psas/lv3.0-camera-ring/README.md

# lv3.0-camera-ring
LV3 360 degree camera ring
