psas/lv3.0-camera-ring/Camera Ring/360_RunCam_Ring.SLDASM

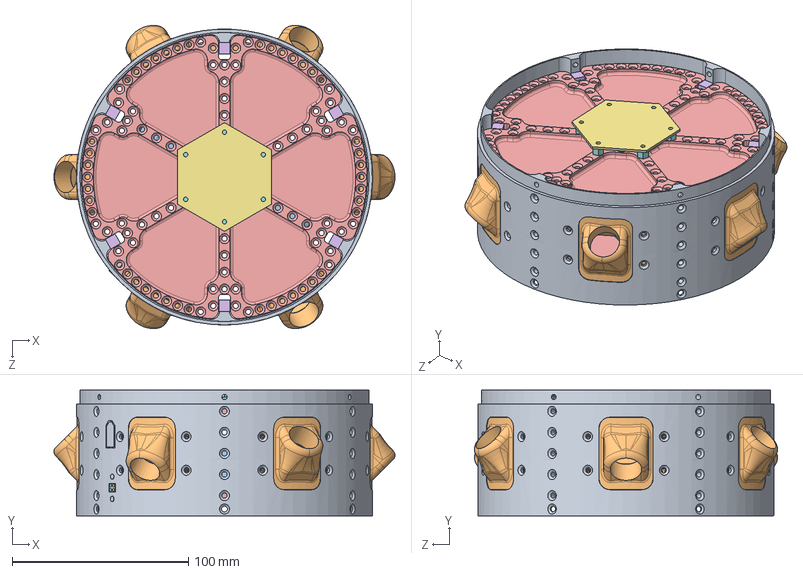
[picture p3: CAD file, 2018-02-22]
Camera Ring/360_RunCam_Ring.SLDASM
193.2 x 71.1 x 171.8 mm
360_RunCam_Ring
RunCam Cradle x 6
4-40x0.375_torx_socketHead_92610A106_BLACK-OXIDE ALLOY STEEL SOCKET HEAD CAP SCREW x 6
No4x0.312_clippedWasher_96025A124_STEEL ANTI-ROTATING CLIPPED WASHER x 6
Camera Bulkhead x 2
bulkheadBracket x 12
Camera Control Board
Stand Off x 6
XT-60_Macho
PinoXT-60_Macho x 2
FUNDA
NUCLEO
JST XHP-4
XT60 Buchse
813-22-0xx-30-000101-Single x 2
0900-0-15-20-76-14-11-0-Housing x 4
Magnet x 2
Camera Cradle Clamp
