psas/lv3.0-camera-ring/mechanical/fireHazard/batteryBox.SLDASM

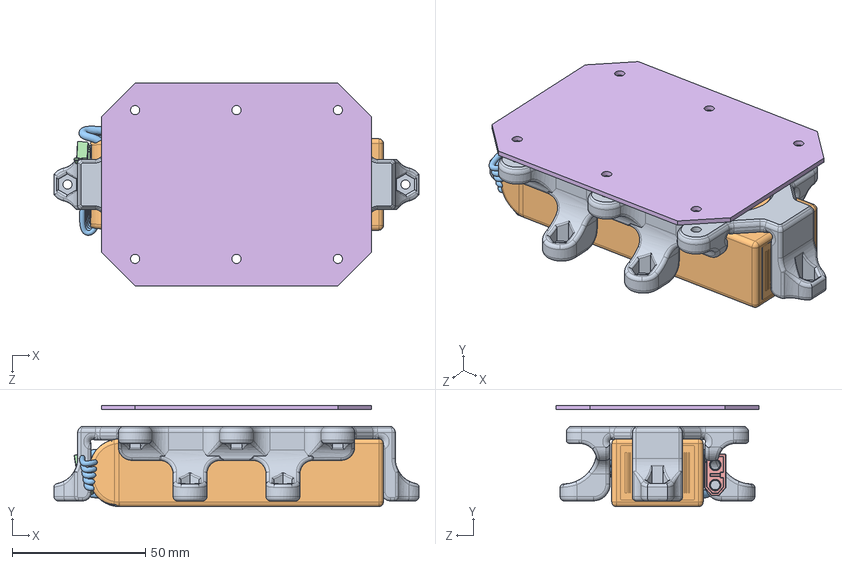
[picture p4: CAD file, 2018-04-08]
mechanical/fireHazard/batteryBox.SLDASM
137.2 x 38.0 x 76.2 mm
batteryDome
FUNDA
NUCLEO
JST XHP-4
XT60 Buchse
cameraMasterBoard
