psas/lv3.0-camera-ring/mechanical/camera/horizontalCradle.SLDASM

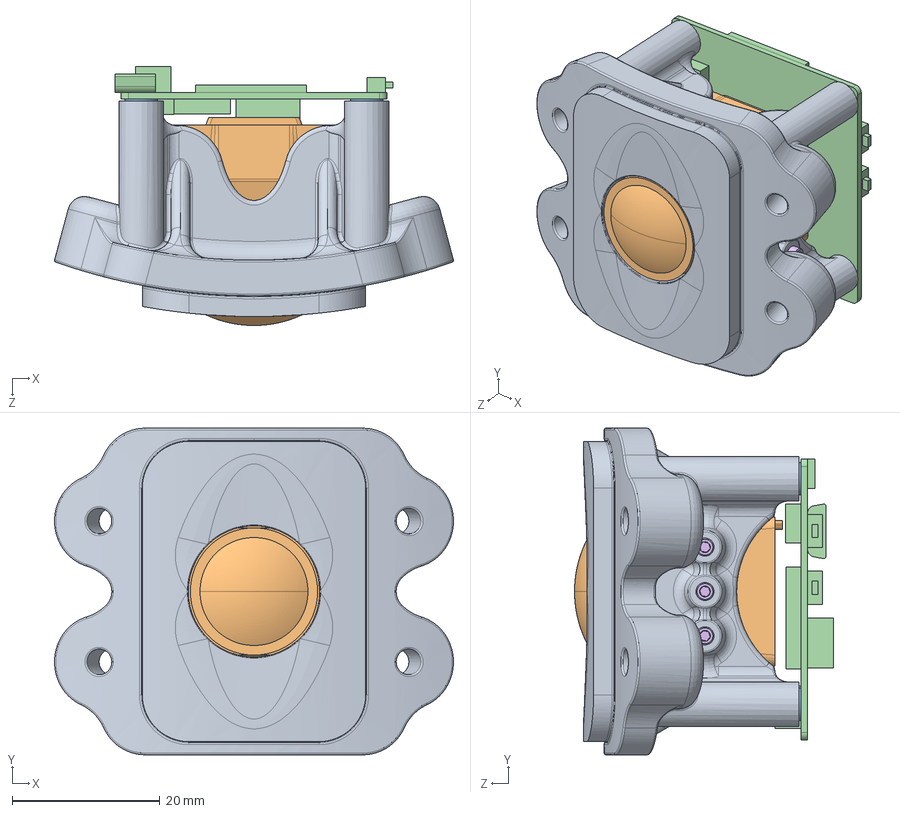
[picture p5: CAD file, 2018-03-23]
mechanical/camera/horizontalCradle.SLDASM
54.0 x 44.2 x 35.0 mm
horizontalCradle
Cam-gopro-lens
4-40_heatInsert_93365A122_BRASS HEAT-SET INSERT FOR PLASTICS x 4
Split-Platine
0-80_nut_91841A115_TYPE 18-8 STAINLESS STEEL HEX NUT x 6
0-80x0.25_capHeadScrew_91251A055_BLACK-OXIDE ALLOY STEEL SOCKET HEAD CAP SCREW x 6
