psas/lv3.0-camera-ring/mechanical/camera/axialCradle.SLDASM

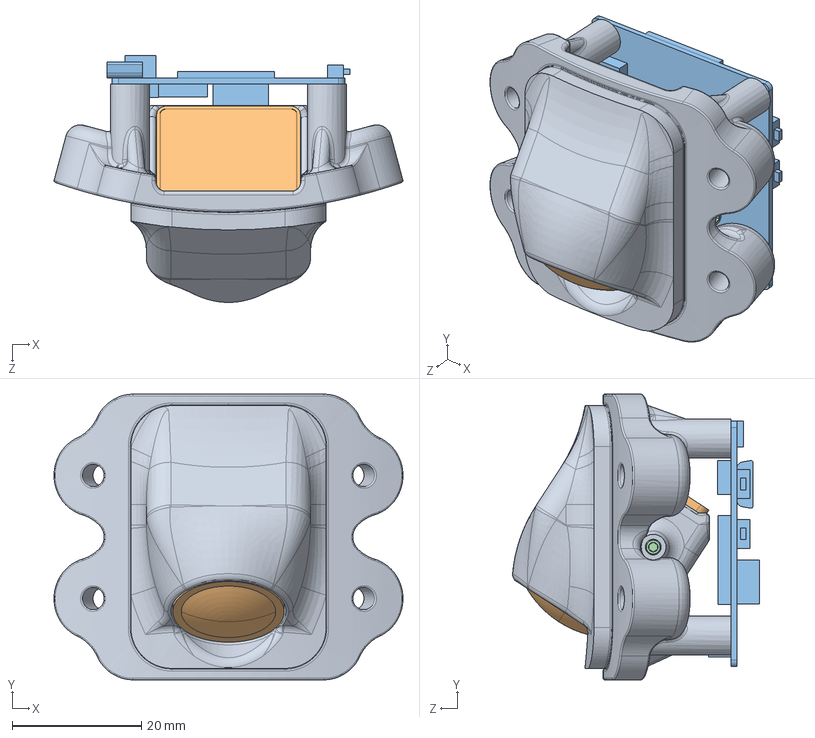
[picture p6: CAD file, 2018-03-23]
mechanical/camera/axialCradle.SLDASM
54.0 x 44.2 x 38.2 mm
axialCradle
Cam-gopro-lens
Split-Platine
0-80x0.25_capHeadScrew_91251A055_BLACK-OXIDE ALLOY STEEL SOCKET HEAD CAP SCREW x 2
0-80_nut_91841A115_TYPE 18-8 STAINLESS STEEL HEX NUT x 2
