psas/lv3.0-camera-ring/mechanical/camera/runCamCradle.SLDASM

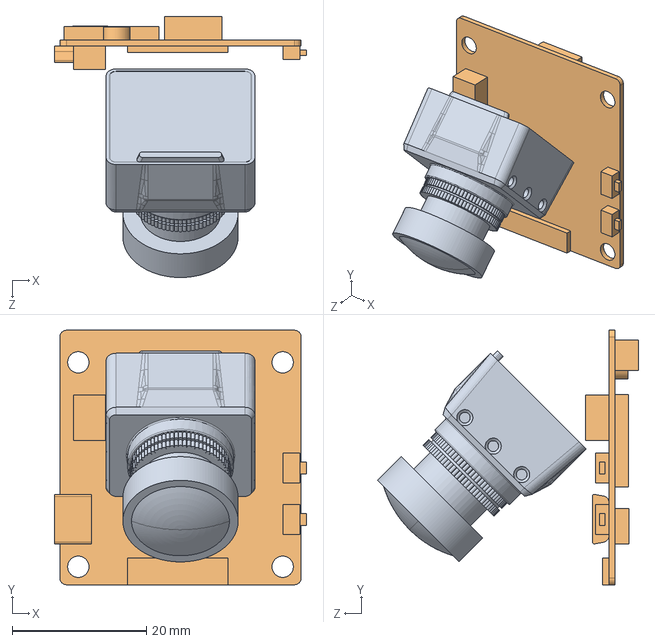
[picture p7: CAD file, 2018-03-09]
mechanical/camera/runCamCradle.SLDASM
37.6 x 38.0 x 38.9 mm
Cam-gopro-lens
Split-Platine
