psas/lv3.0-camera-ring/mechanical/structure/umbilicalRing.SLDASM

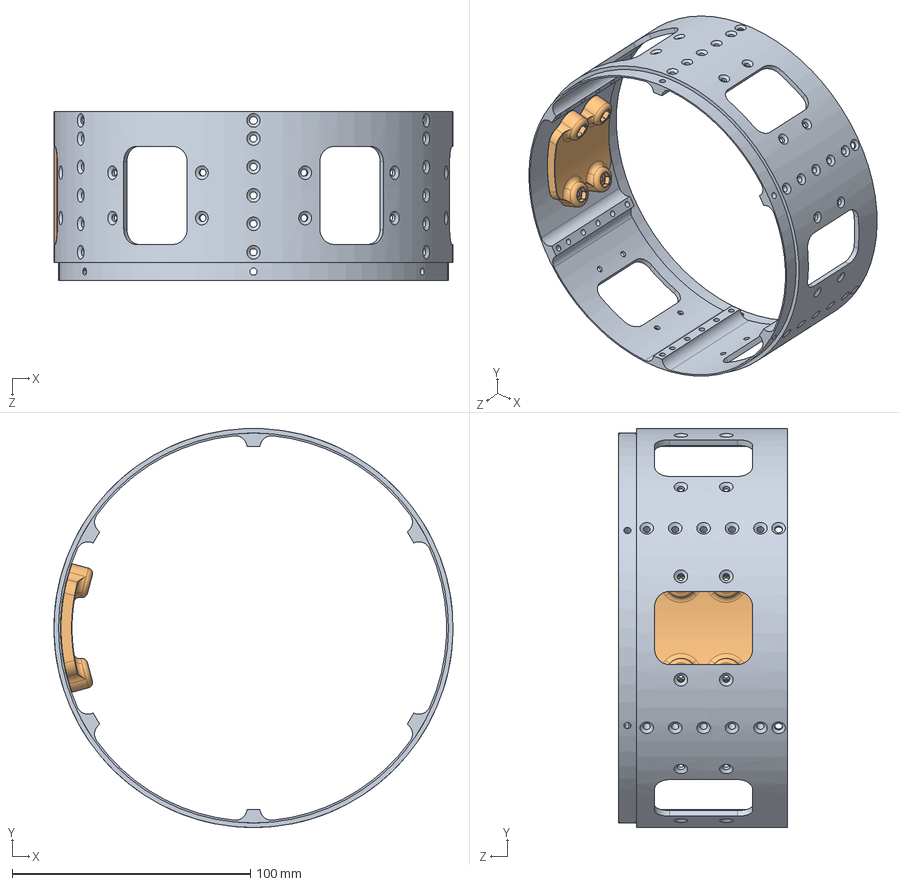
[picture p8: CAD file, 2018-03-09]
mechanical/structure/umbilicalRing.SLDASM
167.6 x 167.6 x 71.1 mm
passthroughRing
windowPlug
