psas/lv3.0-camera-ring/mechanical/camera/cameraSocket.SLDPRT

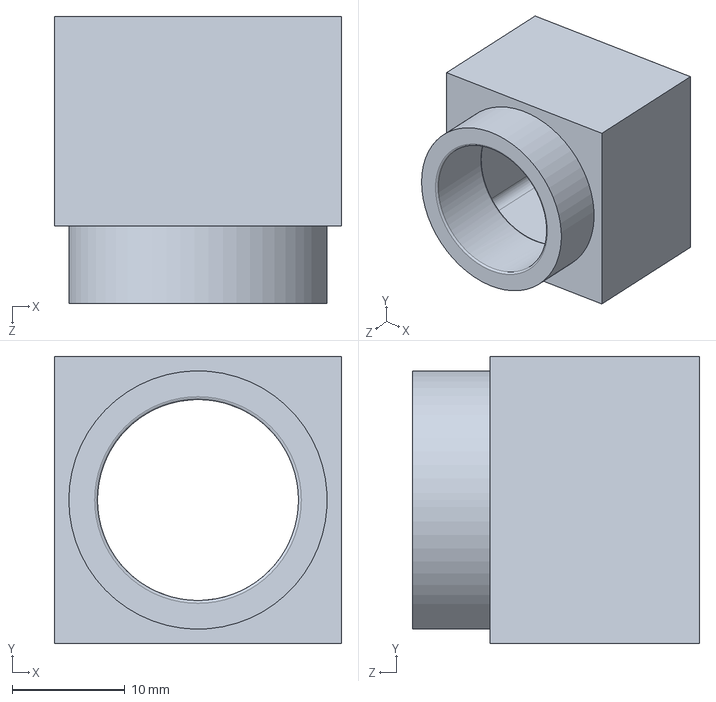
[picture p9: CAD file, 2018-04-02]
mechanical/camera/cameraSocket.SLDPRT
25.4 x 25.4 x 25.4 mm
