psas/lv3.0-camera-ring/mechanical/structure/bulkhead.SLDPRT

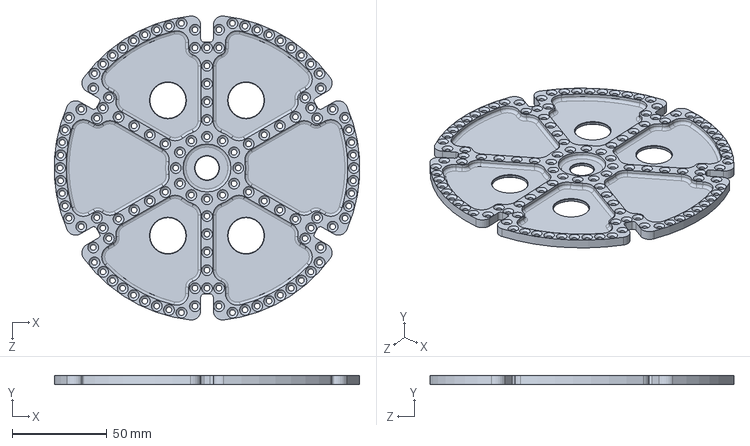
[picture p10: CAD file, 2018-05-13]
mechanical/structure/bulkhead.SLDPRT
161.3 x 4.76 x 160.6 mm
