psas/lv3.0-camera-ring/mechanical/fireHazard/cameraMasterBoard.SLDPRT

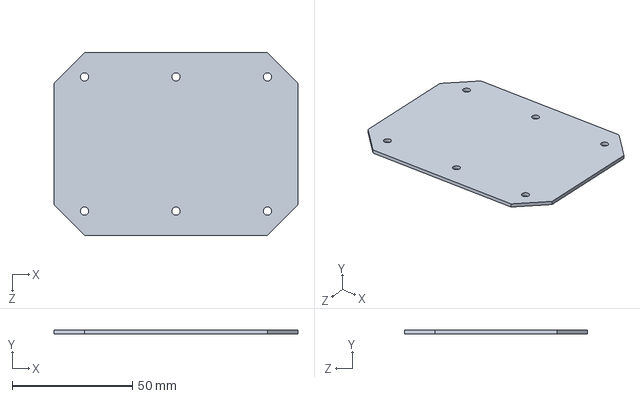
[picture p11: CAD file, 2018-04-08]
mechanical/fireHazard/cameraMasterBoard.SLDPRT
101.6 x 1.60 x 76.2 mm
