psas/lv3.0-camera-ring/mechanical/structure/bulkheadBracket_straightHole.SLDPRT

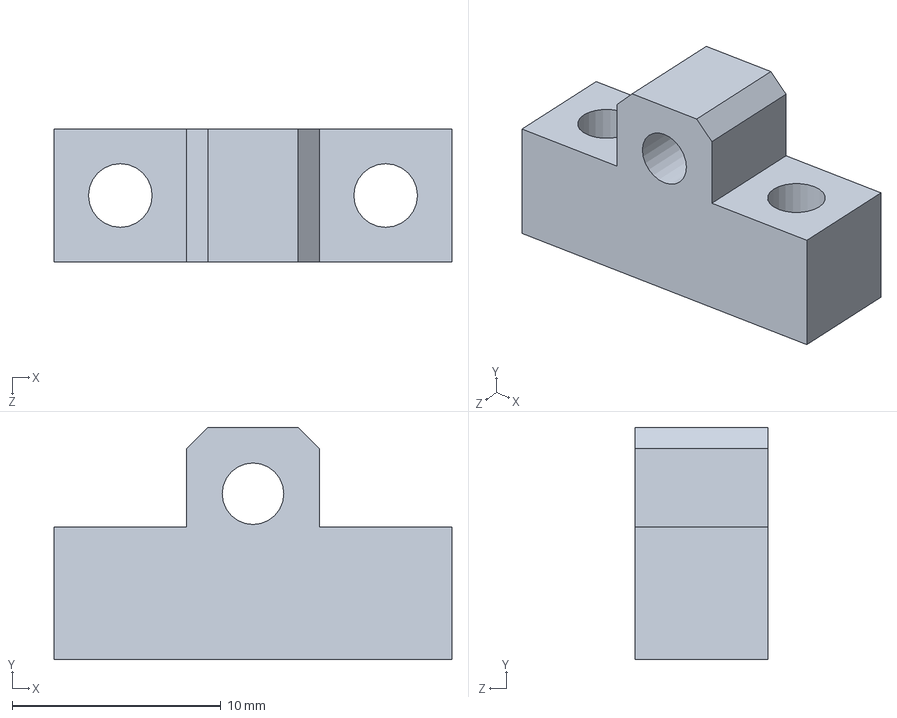
[picture p12: CAD file, 2018-03-22]
mechanical/structure/bulkheadBracket_straightHole.SLDPRT
19.1 x 11.1 x 6.35 mm
