psas/lv3.0-camera-ring/mechanical/fireHazard/batteryDome.SLDPRT

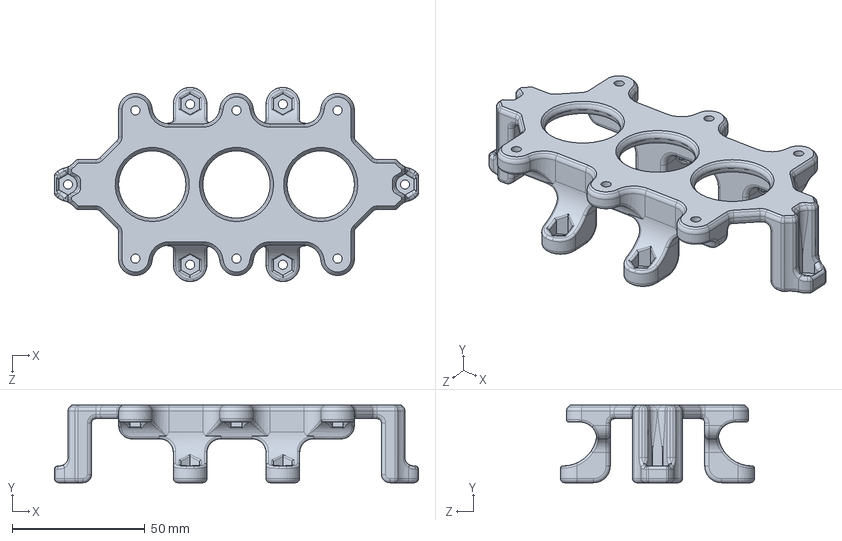
[picture p13: CAD file, 2018-04-08]
mechanical/fireHazard/batteryDome.SLDPRT
137.2 x 29.2 x 73.2 mm
