psas/lv3.0-camera-ring/mechanical/structure/bulkheadBracket.SLDPRT

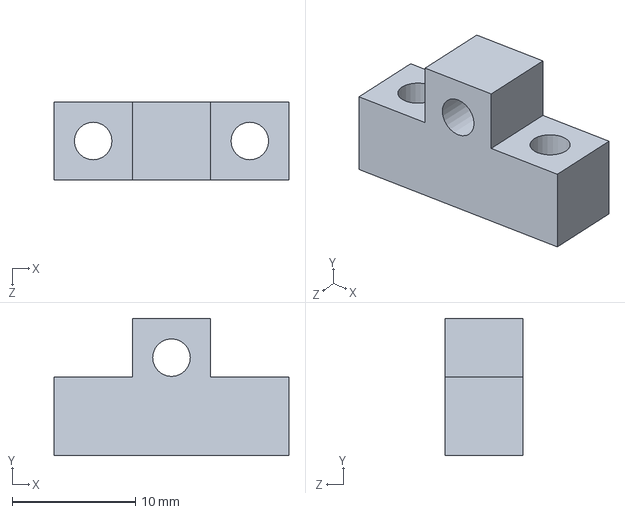
[picture p14: CAD file, 2018-03-22]
mechanical/structure/bulkheadBracket.SLDPRT
19.1 x 11.1 x 6.35 mm
