psas/lv3.0-camera-ring/mechanical/fireHazard/batteryBox_zipTie.sldprt

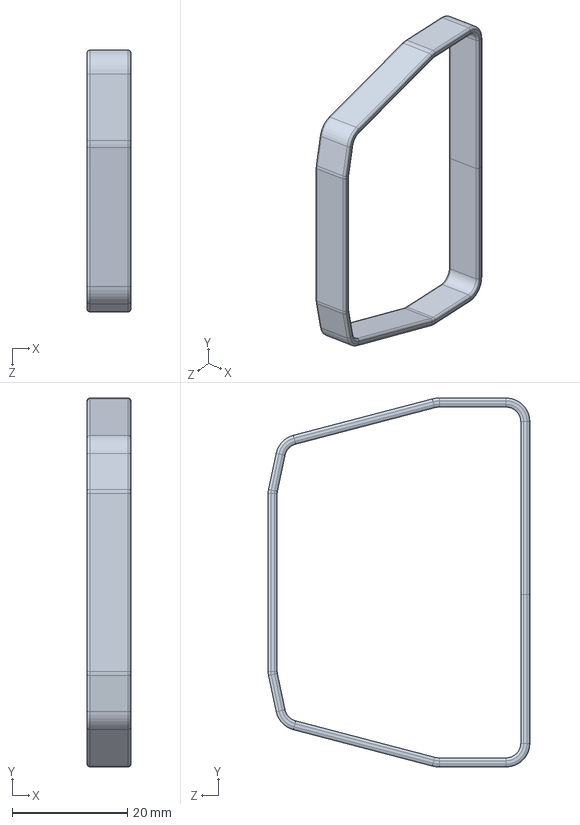
[picture p15: CAD file, 2018-03-01]
mechanical/fireHazard/batteryBox_zipTie.sldprt
7.62 x 64.1 x 45.5 mm
