psas/lv3.0-camera-ring/mechanical/fireHazard/batteryFoamCushion.SLDPRT

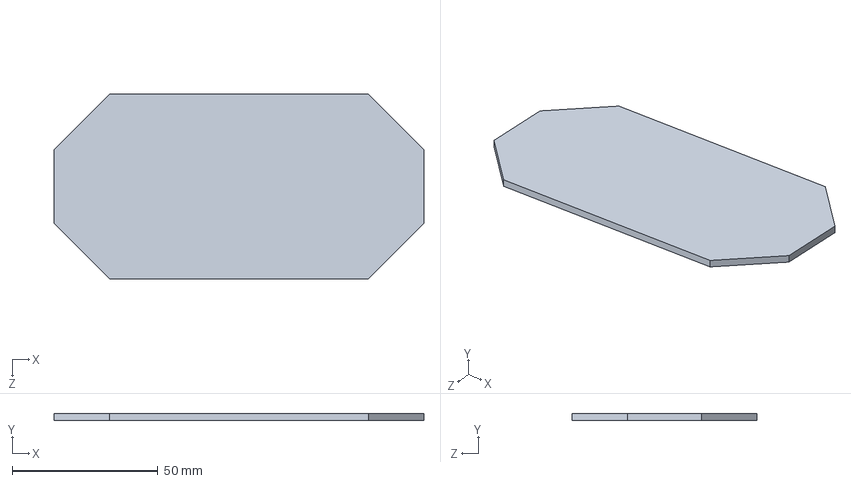
[picture p16: CAD file, 2018-03-01]
mechanical/fireHazard/batteryFoamCushion.SLDPRT
127.0 x 2.54 x 63.5 mm
