psas/lv3.0-camera-ring/mechanical/structure/windowPlug.SLDPRT

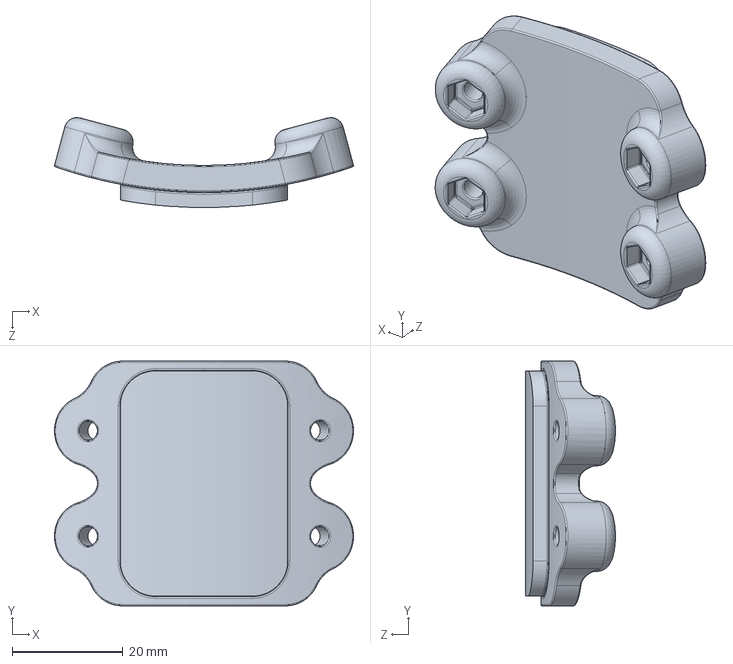
[picture p17: CAD file, 2018-02-28]
mechanical/structure/windowPlug.SLDPRT
54.0 x 44.2 x 16.2 mm
