psas/lv3.0-camera-ring/mechanical/structure/passthroughRing.SLDPRT

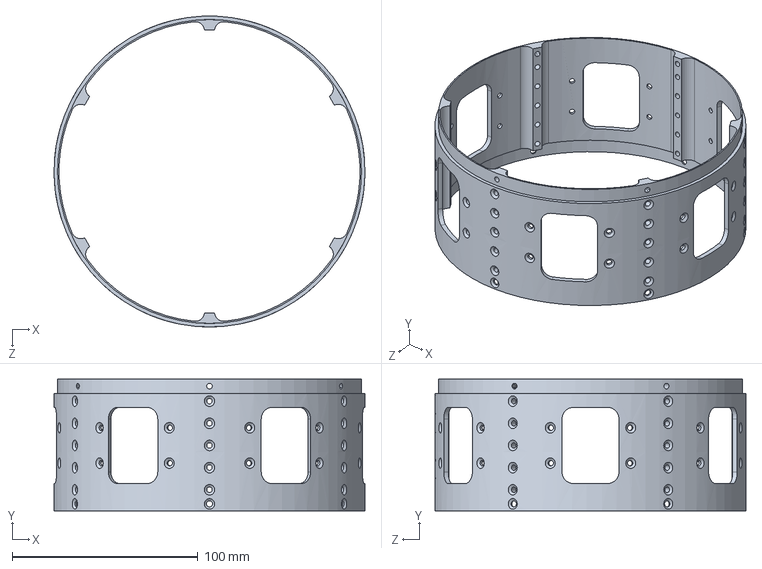
[picture p18: CAD file, 2018-02-22]
mechanical/structure/passthroughRing.SLDPRT
167.6 x 71.1 x 167.6 mm
