psas/lv3.0-camera-ring/mechanical/cots/TATTU 1800mah 4s.SLDASM

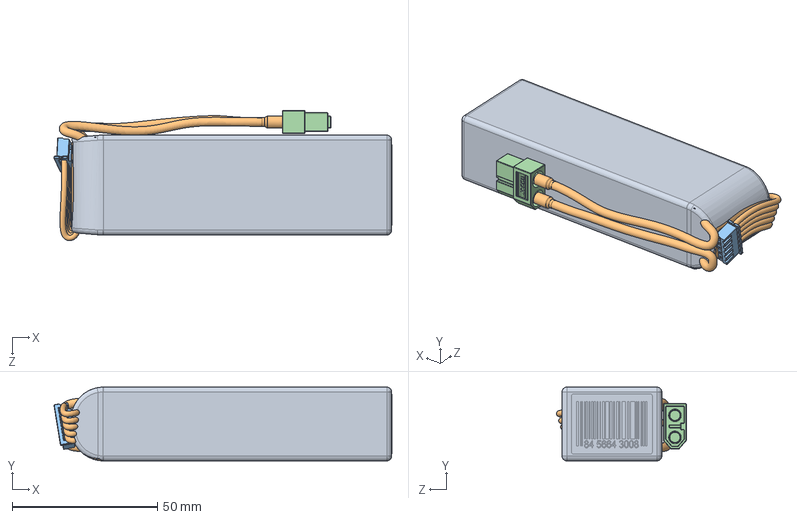
[picture p19: CAD file, 2018-01-24]
mechanical/cots/TATTU 1800mah 4s.SLDASM
116.3 x 25.4 x 44.8 mm
FUNDA
NUCLEO
JST XHP-4
XT60 Buchse
