psas/lv3.0-camera-ring/mechanical/COTS/XT-60_Macho.SLDASM

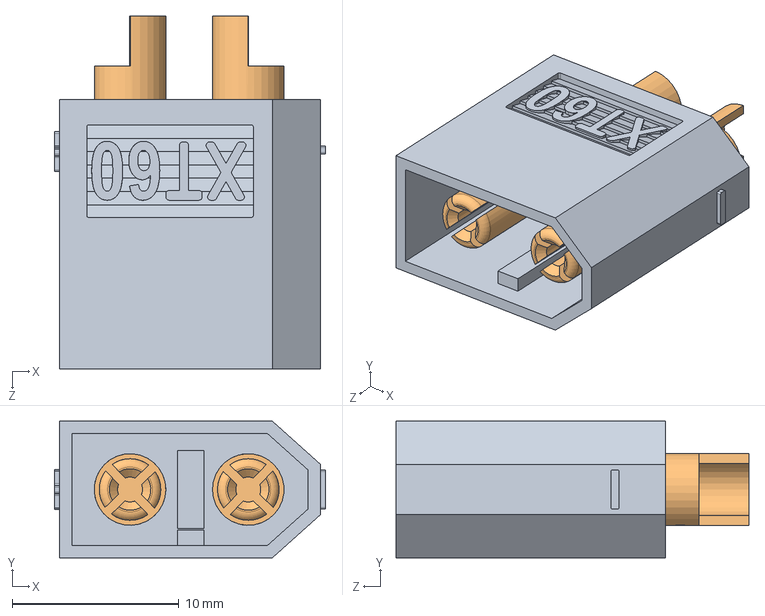
[picture p20: CAD file, 2018-01-24]
mechanical/COTS/XT-60_Macho.SLDASM
16.3 x 8.20 x 21.2 mm
XT-60_Macho
PinoXT-60_Macho x 2
