psas/lv3.0-camera-ring/(list of files, cad)

Other CAD files:
mechanical/COTS/0-80_nut_91841A115_TYPE 18-8 STAINLESS STEEL HEX NUT.SLDPRT
mechanical/COTS/0-80x0.25_capHeadScrew_91251A055_BLACK-OXIDE ALLOY STEEL SOCKET HEAD CAP SCREW.SLDPRT
mechanical/COTS/0900-0-15-20-76-14-11-0-Housing.SLDPRT
mechanical/COTS/4-40_heatInsert_93365A122_BRASS HEAT-SET INSERT FOR PLASTICS.SLDPRT
mechanical/COTS/4-40_insert_99362A200_BRASS TAPPING INSERT FOR PLASTICS.SLDPRT
mechanical/COTS/4-40x0.375_torx_socketHead_92610A106_BLACK-OXIDE ALLOY STEEL SOCKET HEAD CAP SCREW.SLDPRT
mechanical/COTS/813-22-0xx-30-000101-Single.SLDPRT
mechanical/COTS/Cam-gopro-lens.SLDPRT
mechanical/COTS/FUNDA.SLDPRT
mechanical/COTS/JST XHP-4.sldprt
mechanical/COTS/M2x10_torx_buttonHead_92832A113_CLASS 8.8 TORX BUTTON-HEAD SOCKET CAP SCREW.SLDPRT
mechanical/COTS/Magnet.SLDPRT
mechanical/COTS/MillMax-2x.SLDASM
mechanical/COTS/MillMax-2x2.SLDASM
mechanical/COTS/NUCLEO.SLDPRT
mechanical/COTS/No4x0.312_clippedWasher_96025A124_STEEL ANTI-ROTATING CLIPPED WASHER.SLDPRT
mechanical/COTS/No4x0.562_doubleClippedWasher_96025A172_STEEL ANTI-ROTATING CLIPPED WASHER.SLDPRT
mechanical/COTS/PinoXT-60_Macho.SLDPRT
mechanical/COTS/XT-60_Macho.SLDPRT
mechanical/COTS/XT60 Buchse.SLDPRT
mechanical/camera/FOVDiagram.SLDDRW
mechanical/camera/axialCradle.SLDPRT
mechanical/camera/runCamCradle.SLDPRT
mechanical/cots/Split-Platine.SLDPRT
mechanical/cots/Stand Off.SLDPRT
mechanical/fireHazard/batteryBox.SLDPRT
mechanical/fireHazard/batteryDome.SLDDRW
mechanical/fireHazard/batteryFoamCushion.SLDDRW
mechanical/fireHazard/cameraMasterBoard.SLDDRW
mechanical/structure/bulkhead.SLDDRW
mechanical/structure/bulkheadBracket.SLDDRW
mechanical/structure/bulkheadBracket_straightHole.SLDDRW
mechanical/structure/bulkhead_holeTemplate.SLDDRW
mechanical/structure/passthroughRing.SLDDRW
