psas/lv3.0-camera-ring/mechanical/camera/cradleAssemblyGuide.PDF

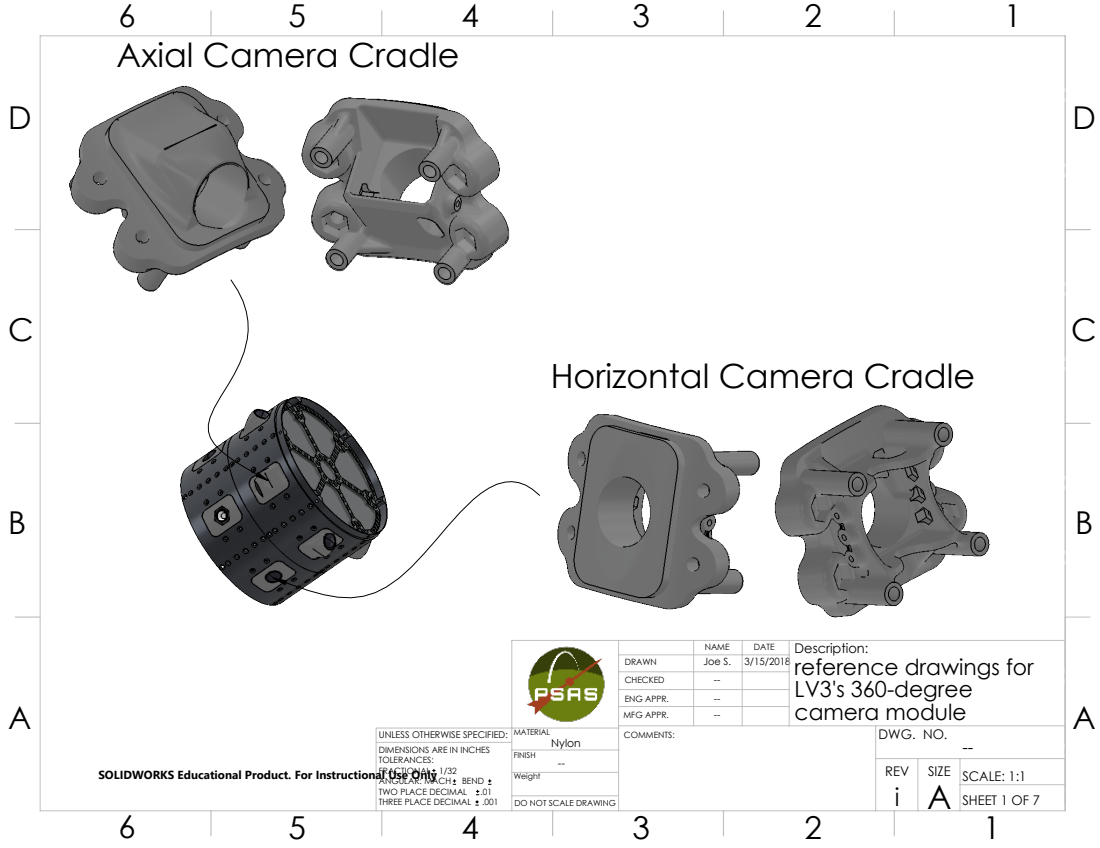
[picture p21: page 1]
REV; SCALE: 1:1; DO NOT SCALE DRAWING; SHEET 1 OF 7

Axial Camera Cradle

Horizontal Camera Cradle

NAME | DATE | Description: reference drawings for LV3's 360-degree camera module

DRAWN | Joe S. | 3/15/2018
CHECKED | --
ENG APPR. | --
MFG APPR. | --

UNLESS OTHERWISE SPECIFIED: | MATERIAL Nylon | COMMENTS: | DWG. NO. --

DIMENSIONS ARE IN INCHES
TOLERANCES:
FRACTIONAL 1/32
ANGULAR: MACH BEND
TWO PLACE DECIMAL .01
THREE PLACE DECIMAL .001

SOLIDWORKS Educational Product. For Instructional Use Only

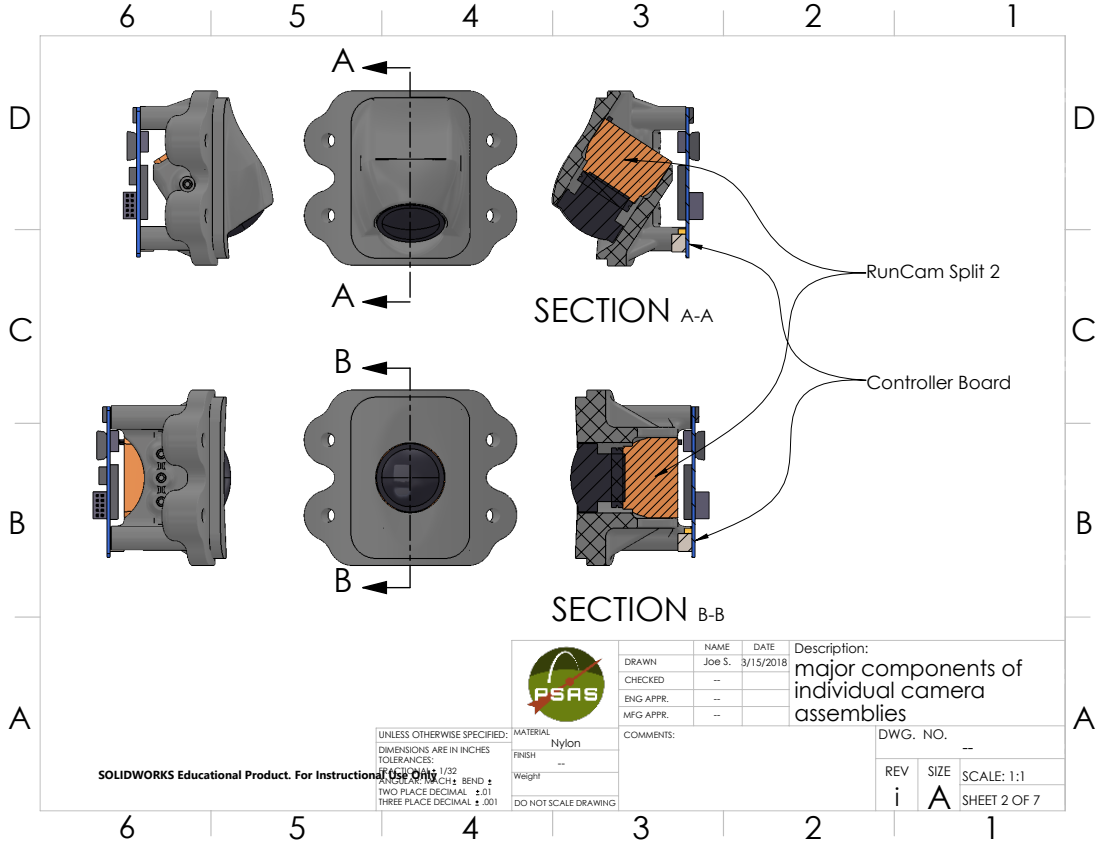
[picture p22: page 2]
SECTION A-A; SECTION B-B; RunCam Split 2; Controller Board; REV; SCALE: 1:1

NAME | DATE | Description: major components of individual camera assemblies

DRAWN | Joe S. | 3/15/2018
CHECKED | --
ENG APPR. | --
MFG APPR. | --

UNLESS OTHERWISE SPECIFIED: | MATERIAL Nylon | COMMENTS: | DWG. NO. --

DIMENSIONS ARE IN INCHES
TOLERANCES:
FRACTIONAL 1/32

SOLIDWORKS Educational Product. For Instructional Use Only

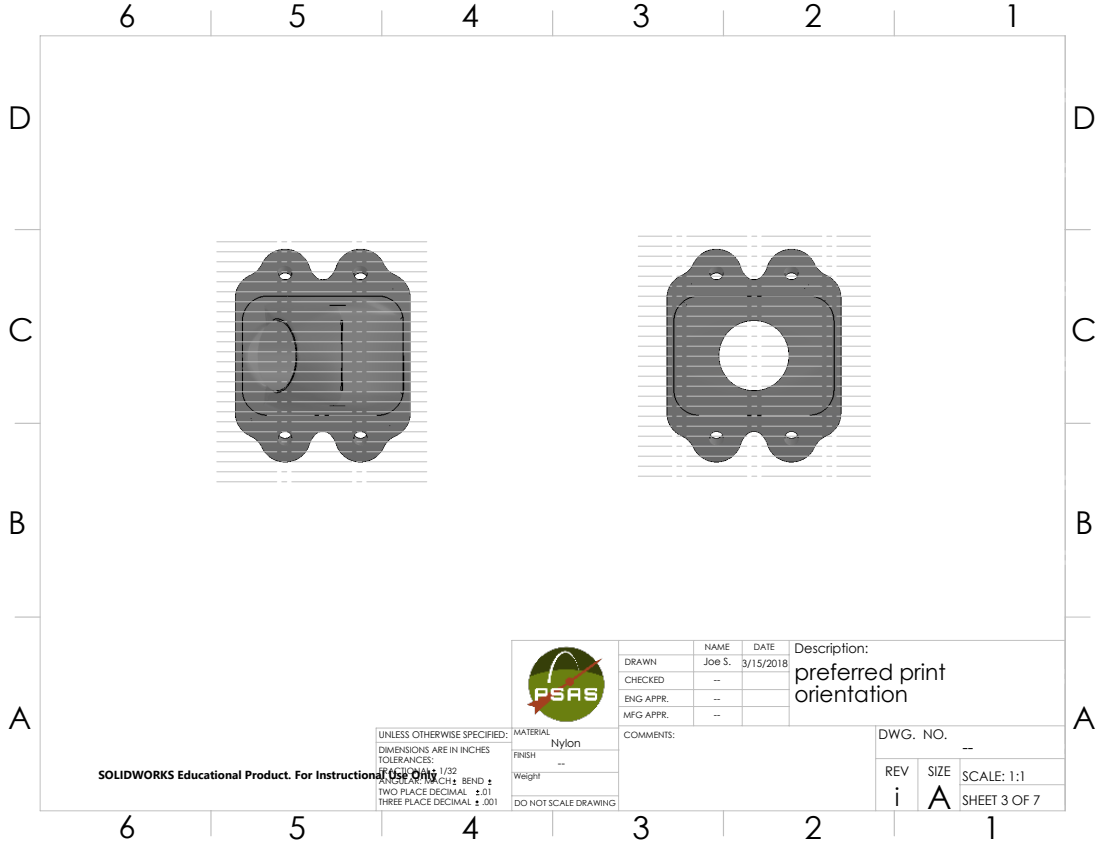
[picture p23: page 3]
REV; SCALE: 1:1

NAME | DATE | Description: preferred print orientation

DRAWN | Joe S. | 3/15/2018
CHECKED | --
ENG APPR. | --
MFG APPR. | --

UNLESS OTHERWISE SPECIFIED: | MATERIAL Nylon | COMMENTS: | DWG. NO. --

DIMENSIONS ARE IN INCHES
TOLERANCES:
FRACTIONAL 1/32

SOLIDWORKS Educational Product. For Instructional Use Only

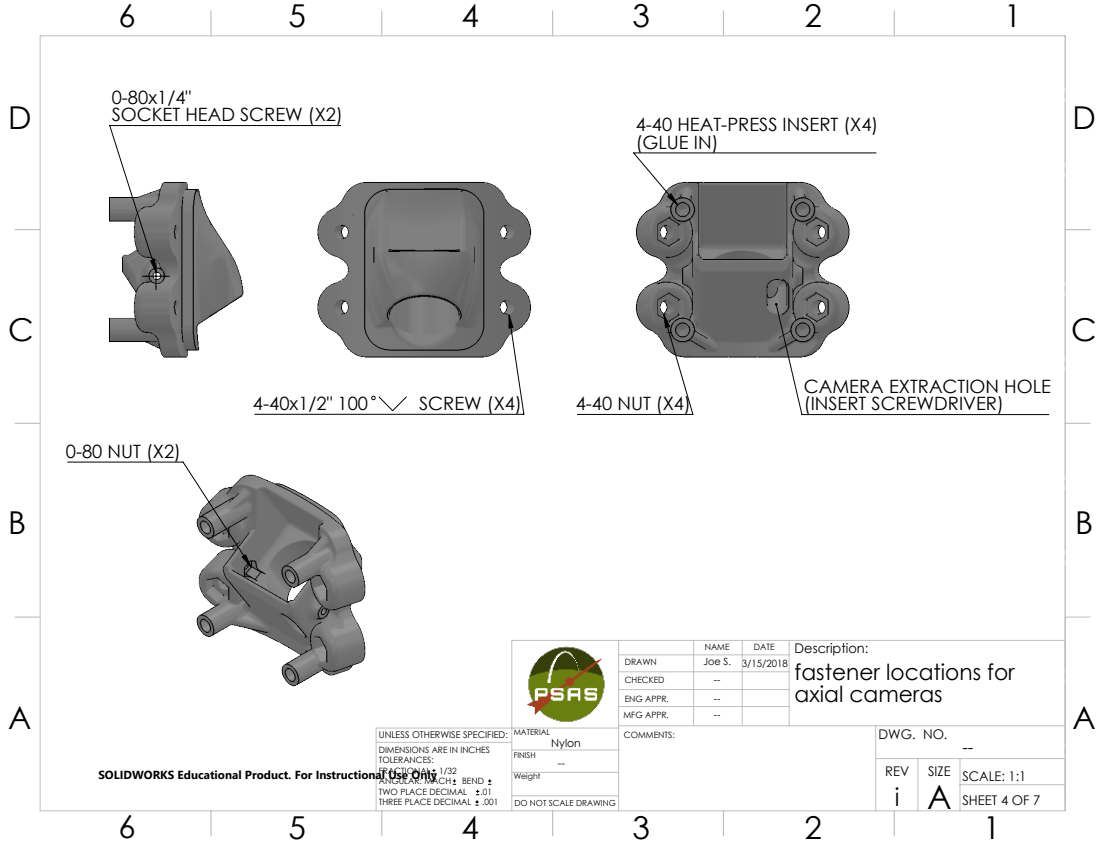
[picture p24: page 4]
SCREW (X4); 4-40 NUT (X4); 0-80 NUT (X2); REV; SCALE: 1:1

SOCKET HEAD SCREW (X2)

4-40 HEAT-PRESS INSERT (X4)
(GLUE IN)

CAMERA EXTRACTION HOLE
(INSERT SCREWDRIVER)

NAME | DATE | Description: fastener locations for axial cameras

DRAWN | Joe S. | 3/15/2018
CHECKED | --
ENG APPR. | --
MFG APPR. | --

UNLESS OTHERWISE SPECIFIED: | MATERIAL Nylon | COMMENTS: | DWG. NO. --

DIMENSIONS ARE IN INCHES
TOLERANCES:
FRACTIONAL 1/32

SOLIDWORKS Educational Product. For Instructional Use Only

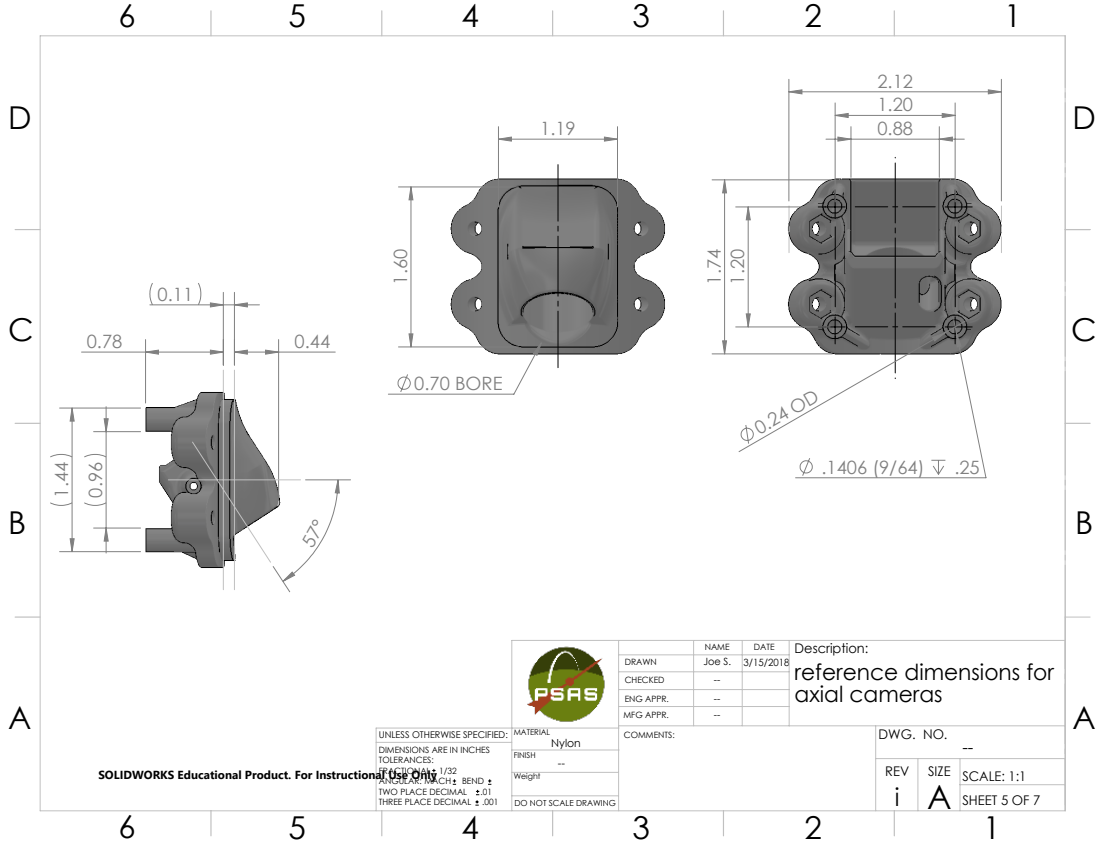
[picture p25: page 5]
0.70 BORE; REV; SCALE: 1:1

NAME | DATE | Description: reference dimensions for axial cameras

DRAWN | Joe S. | 3/15/2018
CHECKED | --
ENG APPR. | --
MFG APPR. | --

UNLESS OTHERWISE SPECIFIED: | MATERIAL Nylon | COMMENTS: | DWG. NO. --

DIMENSIONS ARE IN INCHES
TOLERANCES:
FRACTIONAL 1/32

SOLIDWORKS Educational Product. For Instructional Use Only

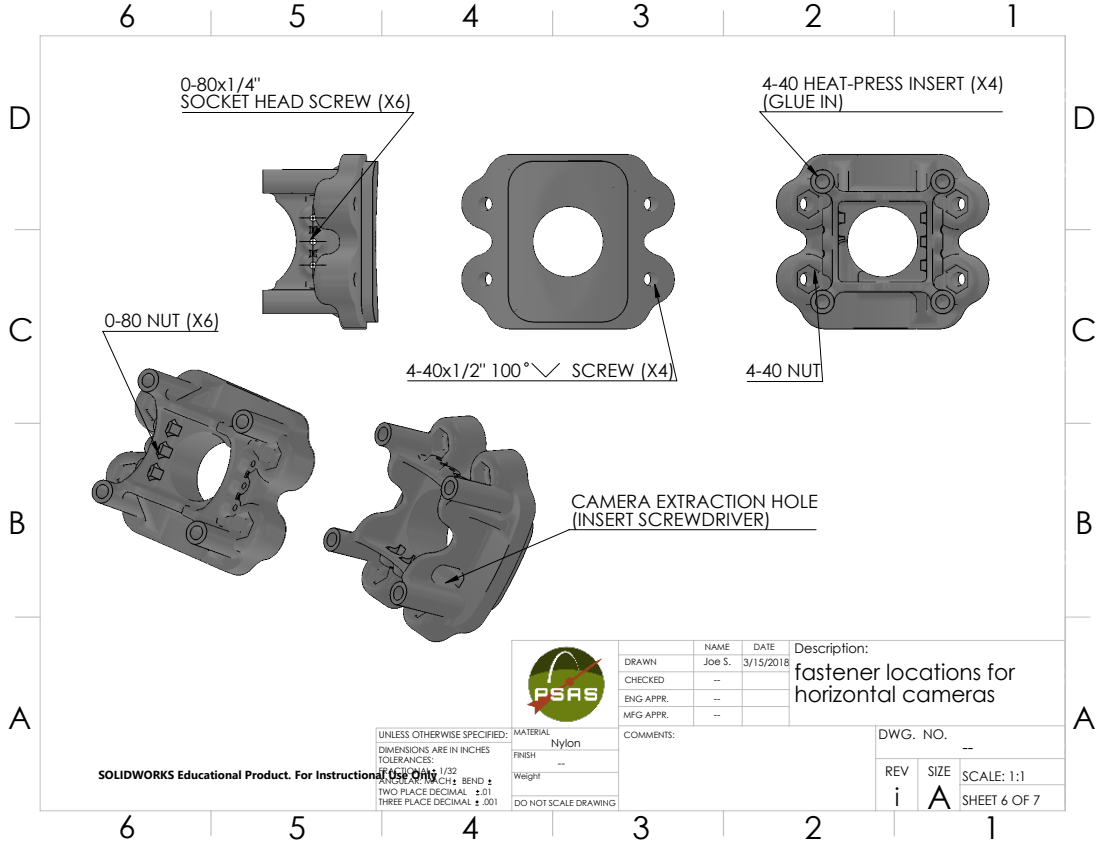
[picture p26: page 6]
SCREW (X4); 4-40 NUT; 0-80 NUT (X6); REV; SCALE: 1:1

SOCKET HEAD SCREW (X6)

4-40 HEAT-PRESS INSERT (X4)
(GLUE IN)

CAMERA EXTRACTION HOLE
(INSERT SCREWDRIVER)

NAME | DATE | Description: fastener locations for horizontal cameras

DRAWN | Joe S. | 3/15/2018
CHECKED | --
ENG APPR. | --
MFG APPR. | --

UNLESS OTHERWISE SPECIFIED: | MATERIAL Nylon | COMMENTS: | DWG. NO. --

DIMENSIONS ARE IN INCHES
TOLERANCES:
FRACTIONAL 1/32

SOLIDWORKS Educational Product. For Instructional Use Only

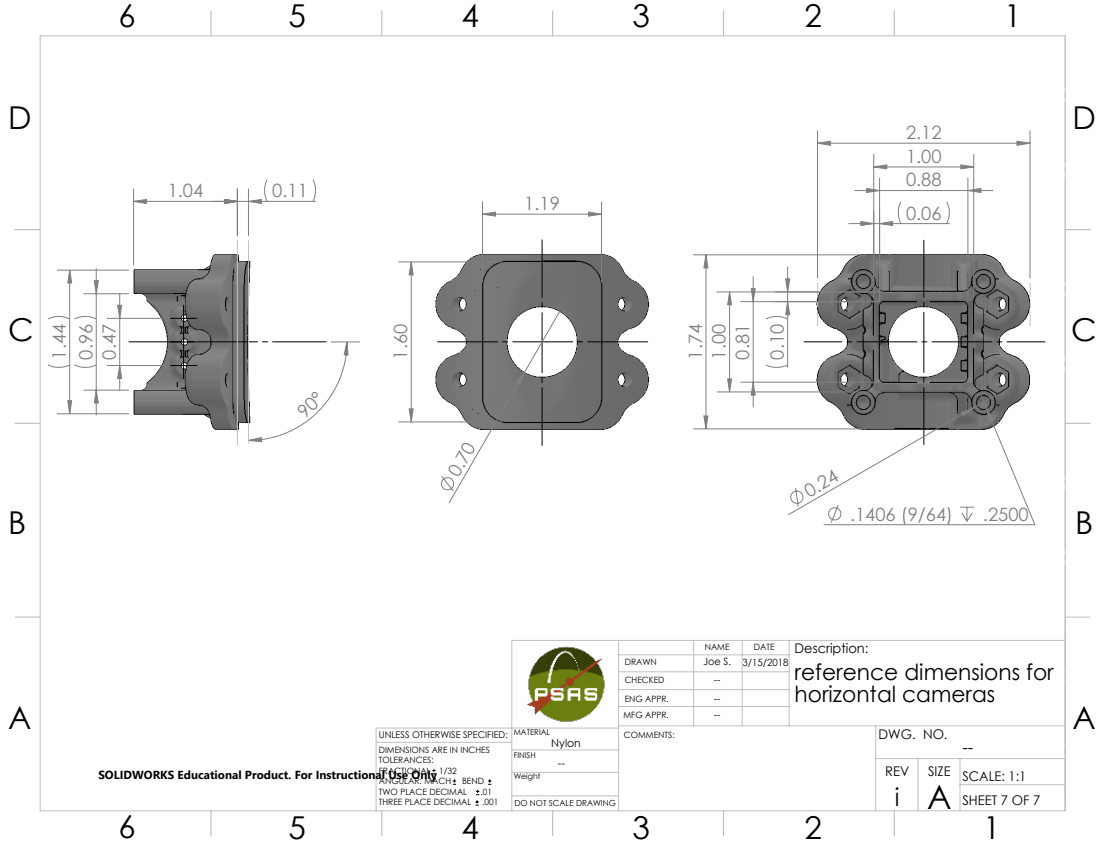
[picture p27: page 7]
REV; SCALE: 1:1

NAME | DATE | Description: reference dimensions for horizontal cameras

DRAWN | Joe S. | 3/15/2018
CHECKED | --
ENG APPR. | --
MFG APPR. | --

UNLESS OTHERWISE SPECIFIED: | MATERIAL Nylon | COMMENTS: | DWG. NO. --

DIMENSIONS ARE IN INCHES
TOLERANCES:
FRACTIONAL 1/32

SOLIDWORKS Educational Product. For Instructional Use Only
