psas/lv3.0-camera-ring/(threads)

Thread 1 (2018-02-21):

Need to know how far the SD card sticks out

Joedang, 2018-02-21:
I set up the camera housing to have a clipped washer that hangs over the SD card to prevent it from jiggling out (see below). You just rotate the washer out of the way when you want to remove the SD card.  After inserting the card, rotate the washer over it and tighten the screw. This way, we can be sure they're secure and also be able to remove them easily.

**I need to know if (and by how much) the SD card will stick out of its socket when inserted**, so I can size this feature so it doesn't press on the SD card.

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

andrewgreenberg, 2018-02-21:
This feature isn't necessary. The RunCam Split 2 uses a metal shield to hold in the SD card. it clips over the card, and the edge of the board too from what I can tell, and holds the SD card in. You pry up the little "finger" that goes over the card, and that's how you take out and insert the SD card.

So I think the washer + bolt is unnecessary.

Joedang, 2018-02-24:
I'm not sure how much we should trust that retainer. It seems like something that would vibrate around during flight. (Though, the washer has the same problem.)

Joedang, 2018-03-01:
Dumping the washer idea, since tape is a thing that exists.

Closed 2018-03-01.

Thread 5 (2018-03-01):

Three more cameras for the umbilical ring?

andrewgreenberg, 2018-03-01:
Because there's no such thing as too many cameras, and the umbilical ring is currently only using three of six ports, what if we add three more cameras out the three remaining ports? This solves our "no horizon" issue on the only 70 deg. vertical FOV on the RunCam Split 2 problem.

battery capacity will be cut down, but I think we're going to find that we actually have plenty of time on batteries given our strategy of turning them on and off remotely.
