psas/lv3.0-camera-ring/mechanical/fireHazard/batteryDome.PDF

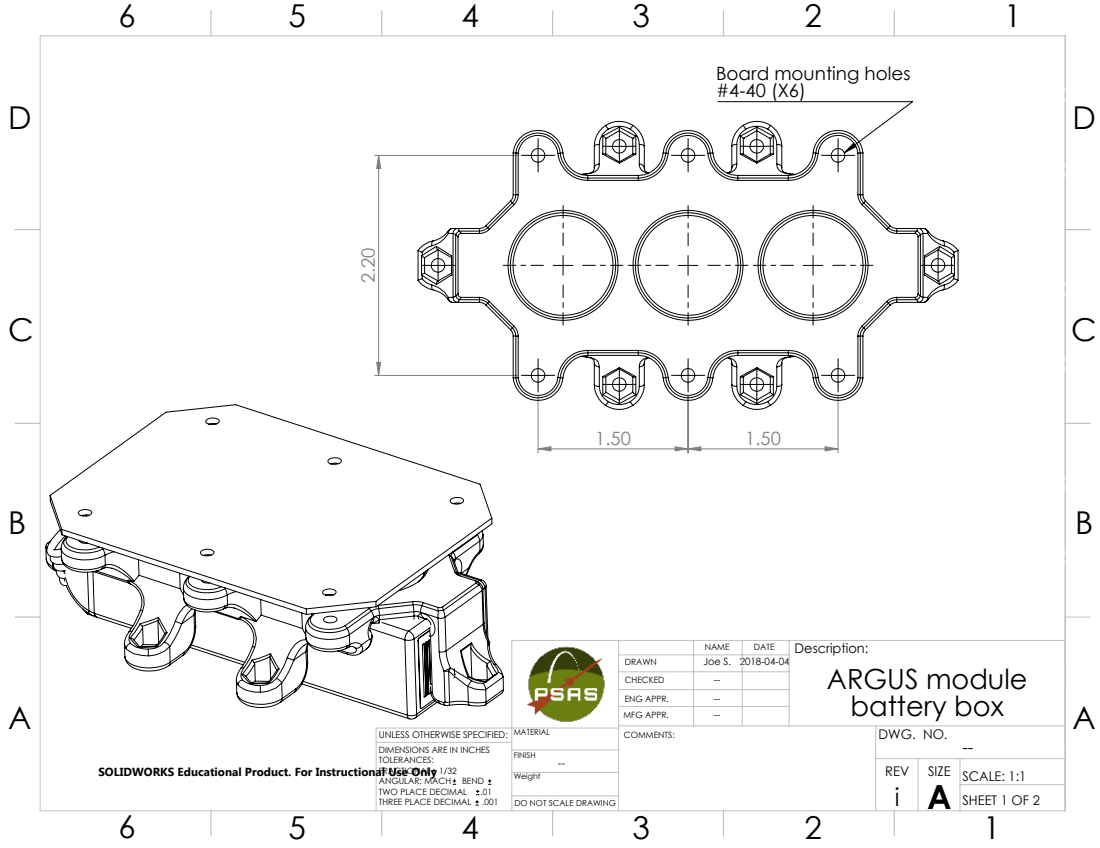
[picture p28: page 1]
REV; SCALE: 1:1; DO NOT SCALE DRAWING; SHEET 1 OF 2

Board mounting holes

NAME | DATE | Description: ARGUS module battery box

DRAWN | Joe S. | 2018-04-04
CHECKED | --
ENG APPR. | --
MFG APPR. | --

UNLESS OTHERWISE SPECIFIED: | MATERIAL | COMMENTS: | DWG. NO. --

DIMENSIONS ARE IN INCHES
TOLERANCES:
FRACTIONAL 1/32
ANGULAR: MACH BEND
TWO PLACE DECIMAL .01
THREE PLACE DECIMAL .001

SOLIDWORKS Educational Product. For Instructional Use Only

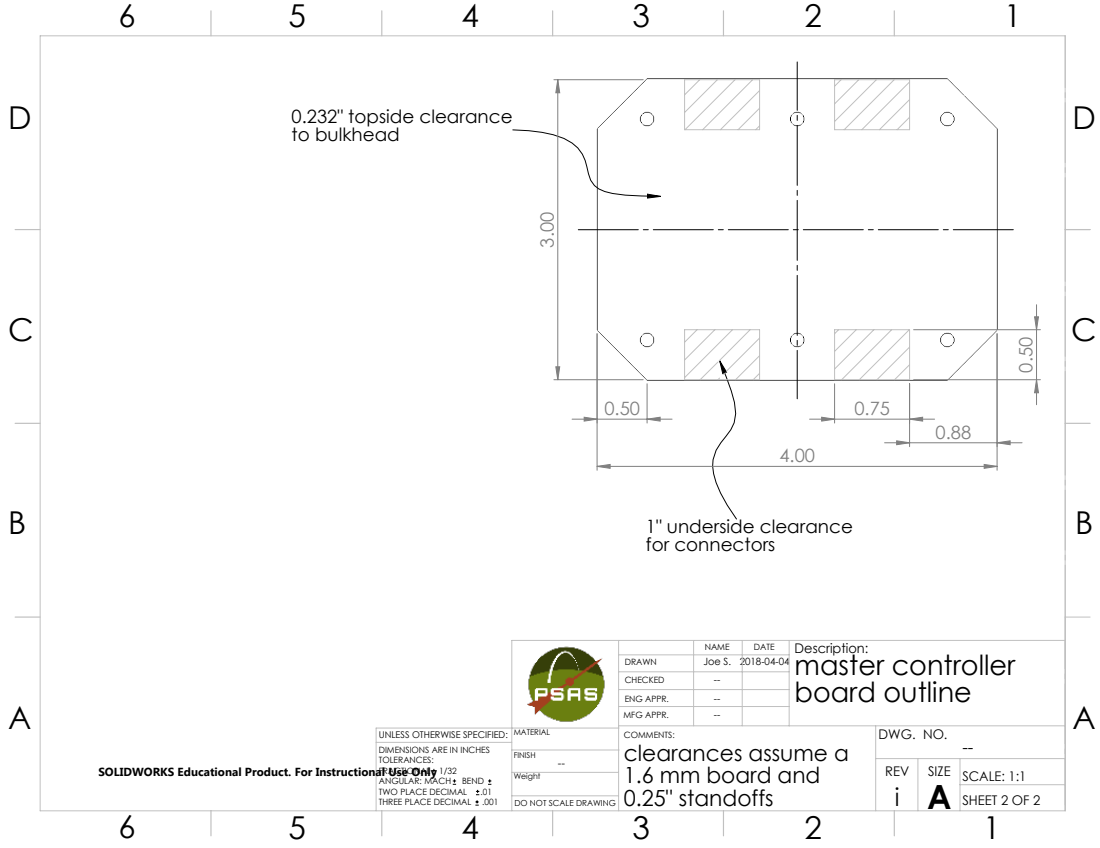
[picture p29: page 2]
1" underside clearance for connectors; 0.232" topside clearance to bulkhead; REV; SCALE: 1:1; DO NOT SCALE DRAWING; SHEET 2 OF 2

NAME | DATE | Description: master controller board outline

DRAWN | Joe S. | 2018-04-04
CHECKED | --
ENG APPR. | --
MFG APPR. | --

UNLESS OTHERWISE SPECIFIED: | MATERIAL | COMMENTS: 1.6 mm board and 0.25" standoffs | DWG. NO. -- clearances assume a

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

SOLIDWORKS Educational Product. For Instructional Use Only
