psas/lv3.0-camera-ring/mechanical/fireHazard/cameraMasterBoard.PDF

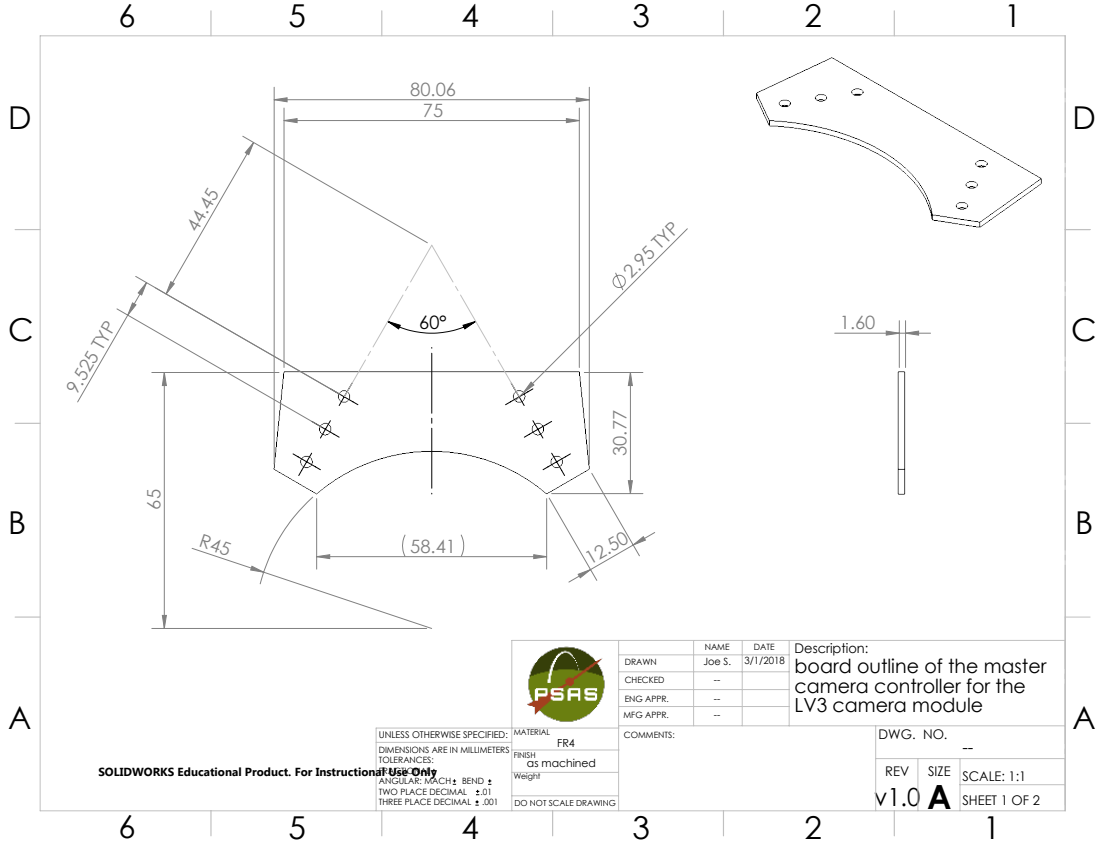
[picture p30: page 1]
9.525 TYP; 2.95 TYP; as machined; REV; SCALE: 1:1; DO NOT SCALE DRAWING; SHEET 1 OF 2

NAME | DATE | Description: board outline of the master camera controller for the LV3 camera module

DRAWN | Joe S. | 3/1/2018
CHECKED | --
ENG APPR. | --
MFG APPR. | --

UNLESS OTHERWISE SPECIFIED: | MATERIAL FR4 | COMMENTS: | DWG. NO. --

DIMENSIONS ARE IN MILLIMETERS
TOLERANCES:
FRACTIONAL
ANGULAR: MACH BEND
TWO PLACE DECIMAL .01
THREE PLACE DECIMAL .001

SOLIDWORKS Educational Product. For Instructional Use Only

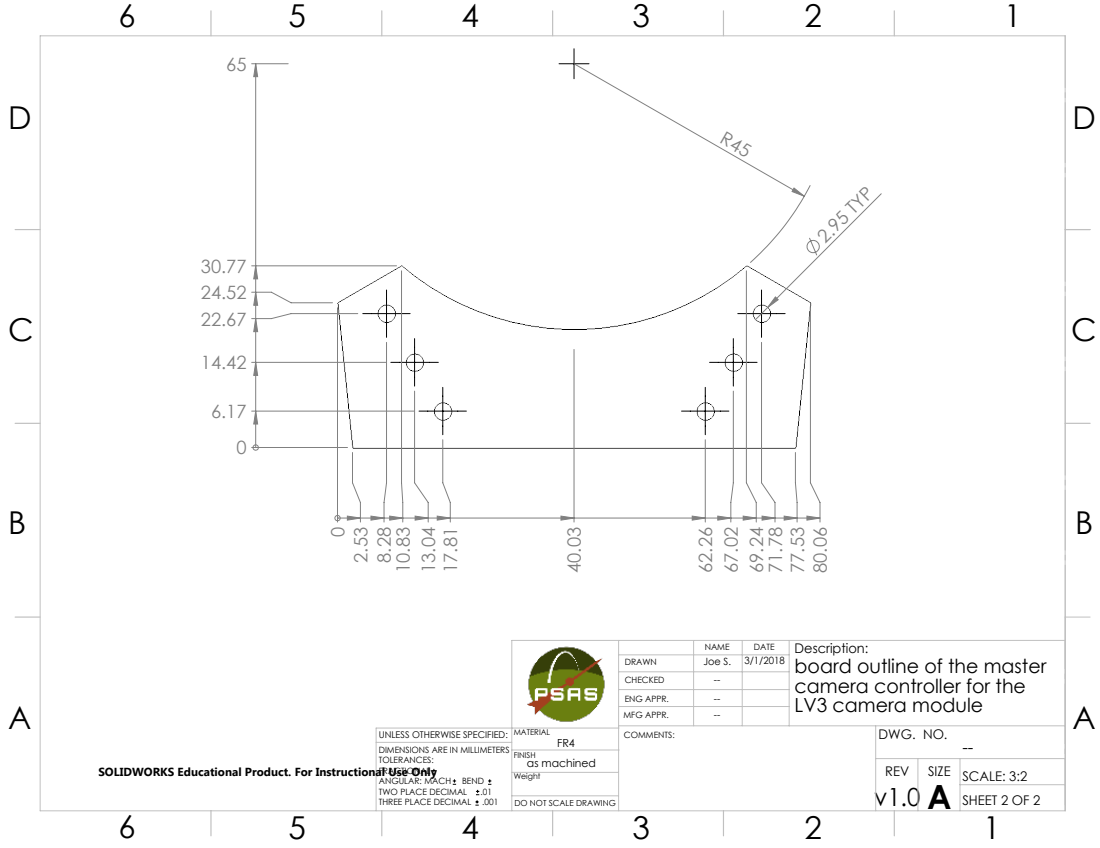
[picture p31: page 2]
2.95 TYP; as machined; REV; SCALE: 3:2; DO NOT SCALE DRAWING; SHEET 2 OF 2

NAME | DATE | Description: board outline of the master camera controller for the LV3 camera module

DRAWN | Joe S. | 3/1/2018
CHECKED | --
ENG APPR. | --
MFG APPR. | --

UNLESS OTHERWISE SPECIFIED: | MATERIAL FR4 | COMMENTS: | DWG. NO. --

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

SOLIDWORKS Educational Product. For Instructional Use Only
