psas/lv3.0-camera-ring/mechanical/structure/bulkheadBracket.PDF

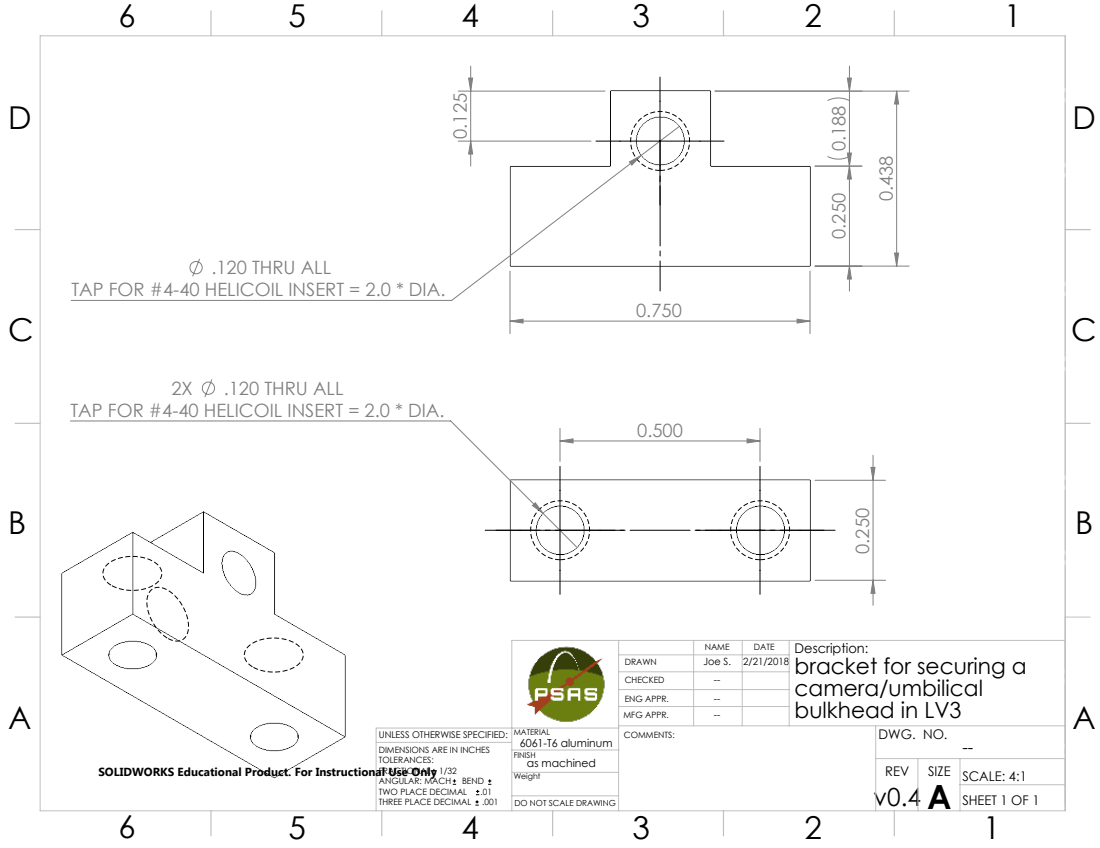
[picture p32: page 1]
.120 THRU ALL; as machined; REV; SCALE: 4:1; DO NOT SCALE DRAWING; SHEET 1 OF 1

TAP FOR #4-40 HELICOIL INSERT = 2.0 * DIA.

NAME | DATE | Description: bracket for securing a camera/umbilical bulkhead in LV3

DRAWN | Joe S. | 2/21/2018
CHECKED | --
ENG APPR. | --
MFG APPR. | --

UNLESS OTHERWISE SPECIFIED: | MATERIAL 6061-T6 aluminum | COMMENTS: | DWG. NO. --

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

SOLIDWORKS Educational Product. For Instructional Use Only
