psas/lv3.0-camera-ring/mechanical/camera/FOVDiagram.PDF

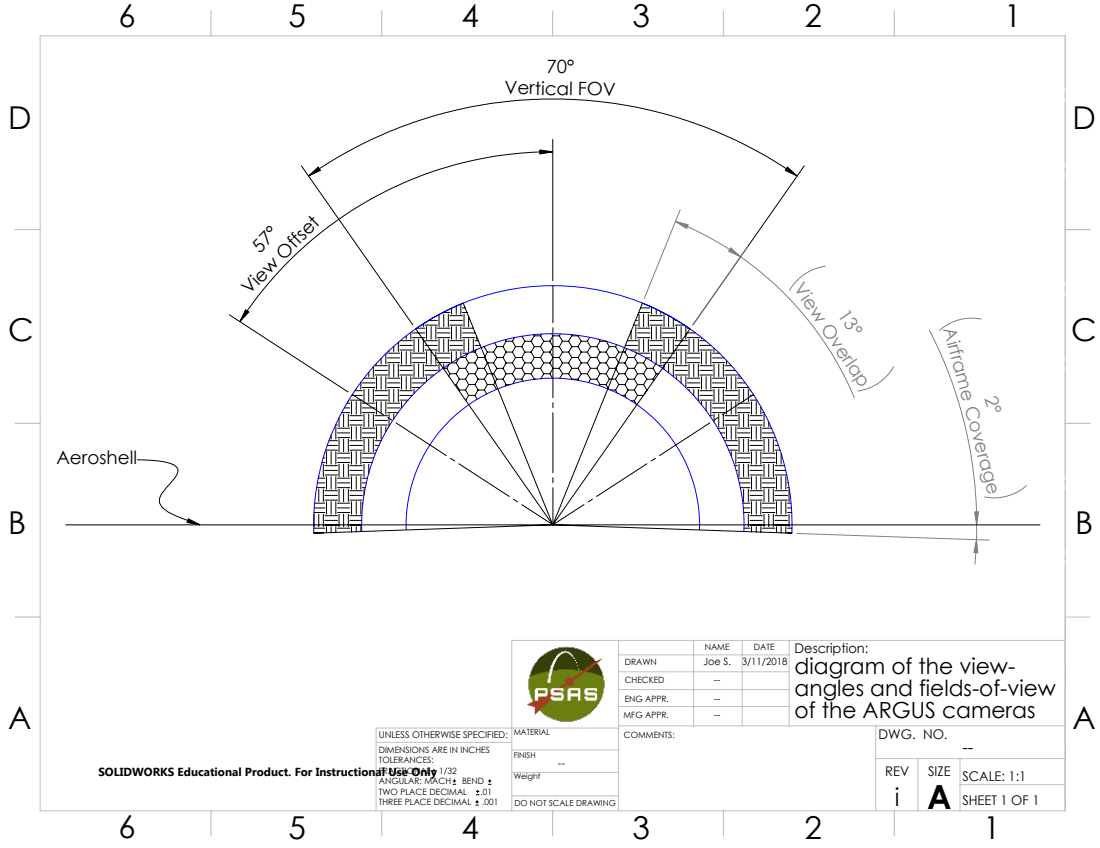
[picture p33: page 1]
Vertical FOV; View Offset; View Overlap; Airframe Coverage; REV; SCALE: 1:1; DO NOT SCALE DRAWING; SHEET 1 OF 1

NAME | DATE | Description: diagram of the view-angles and fields-of-view of the ARGUS cameras

DRAWN | Joe S. | 3/11/2018
CHECKED | --
ENG APPR. | --
MFG APPR. | --

UNLESS OTHERWISE SPECIFIED: | MATERIAL | COMMENTS: | DWG. NO. --

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

SOLIDWORKS Educational Product. For Instructional Use Only
