psas/lv3.0-camera-ring/mechanical/structure/bulkhead.pdf

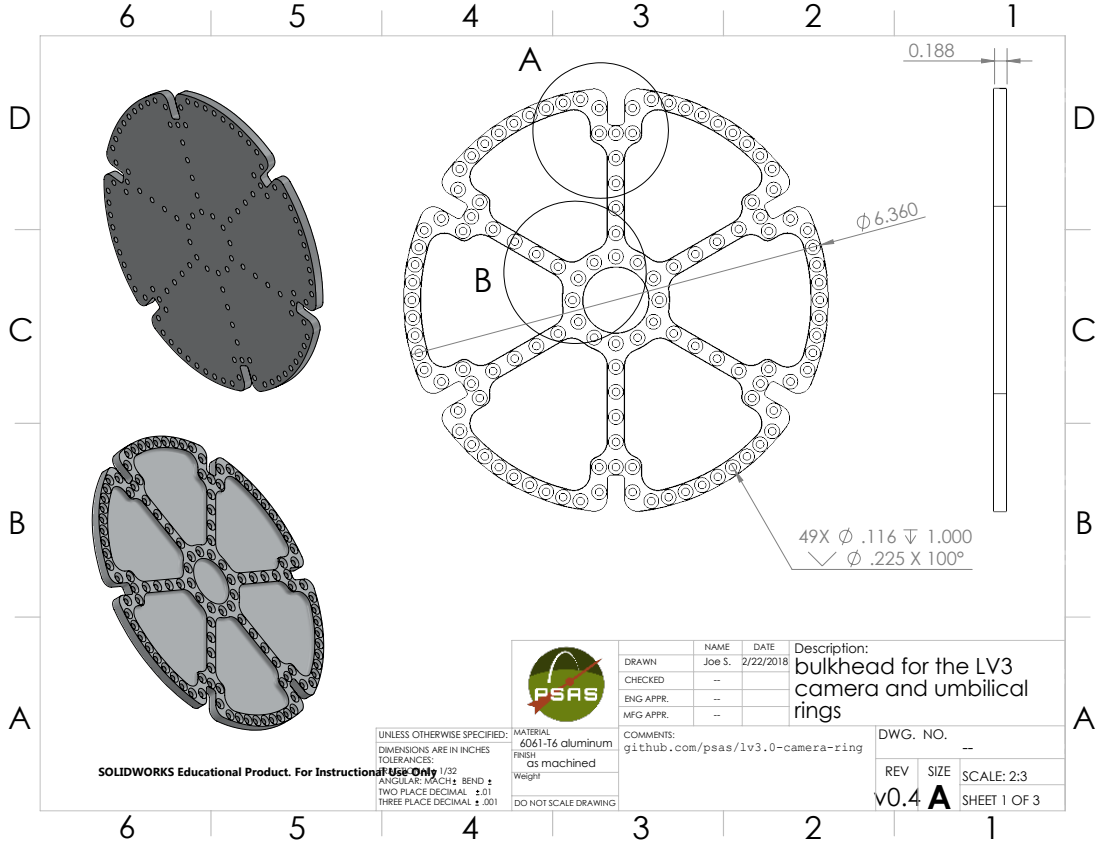
[picture p34: page 1]
as machined; REV; SCALE: 2:3; DO NOT SCALE DRAWING; SHEET 1 OF 3

NAME | DATE | Description: bulkhead for the LV3 camera and umbilical rings

DRAWN | Joe S. | 2/22/2018
CHECKED | --
ENG APPR. | --
MFG APPR. | --

UNLESS OTHERWISE SPECIFIED: | MATERIAL 6061-T6 aluminum | COMMENTS: github.com/psas/lv3.0-camera-ring | DWG. NO. --

DIMENSIONS ARE IN INCHES
TOLERANCES:
FRACTIONAL 1/32
ANGULAR: MACH BEND
TWO PLACE DECIMAL .01
THREE PLACE DECIMAL .001

SOLIDWORKS Educational Product. For Instructional Use Only

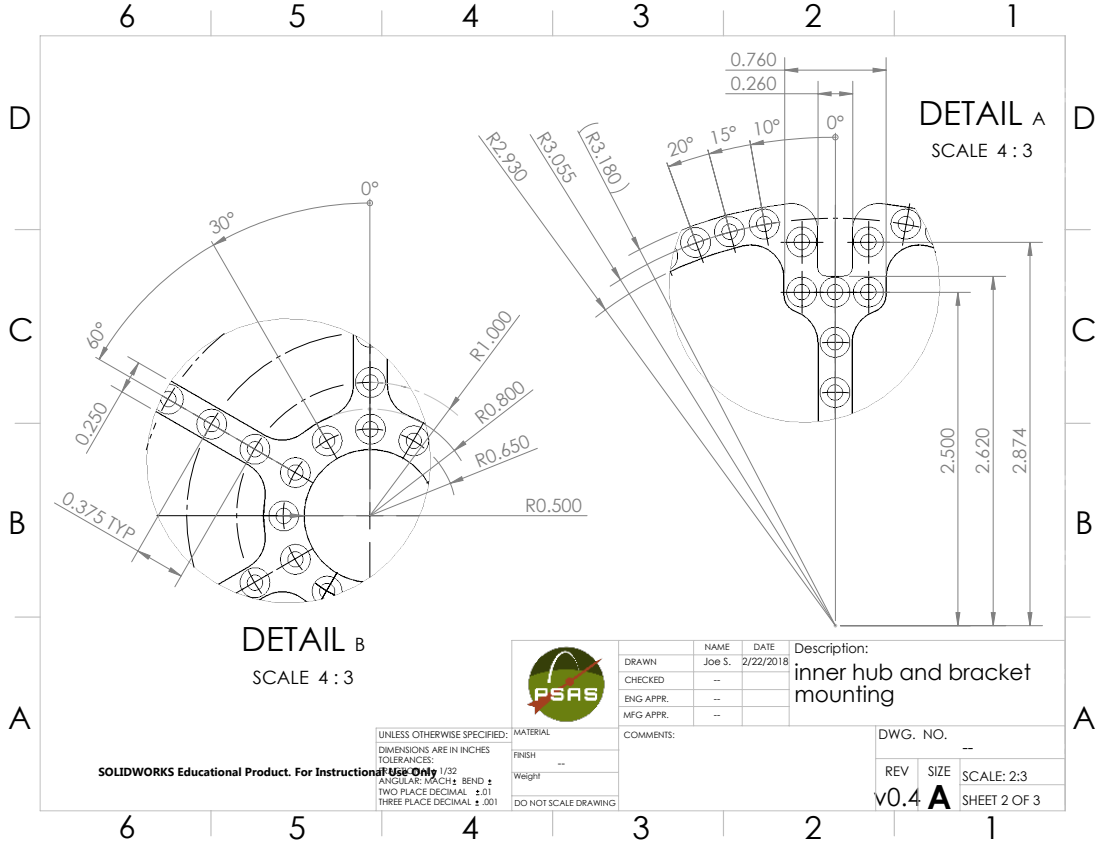
[picture p35: page 2]
DETAIL A; SCALE 4 : 3; 0.375 TYP; DETAIL B; REV; SCALE: 2:3

NAME | DATE | Description: inner hub and bracket mounting

DRAWN | Joe S. | 2/22/2018
CHECKED | --
ENG APPR. | --
MFG APPR. | --

UNLESS OTHERWISE SPECIFIED: | MATERIAL | COMMENTS: | DWG. NO. --

DIMENSIONS ARE IN INCHES
TOLERANCES:
FRACTIONAL 1/32

SOLIDWORKS Educational Product. For Instructional Use Only

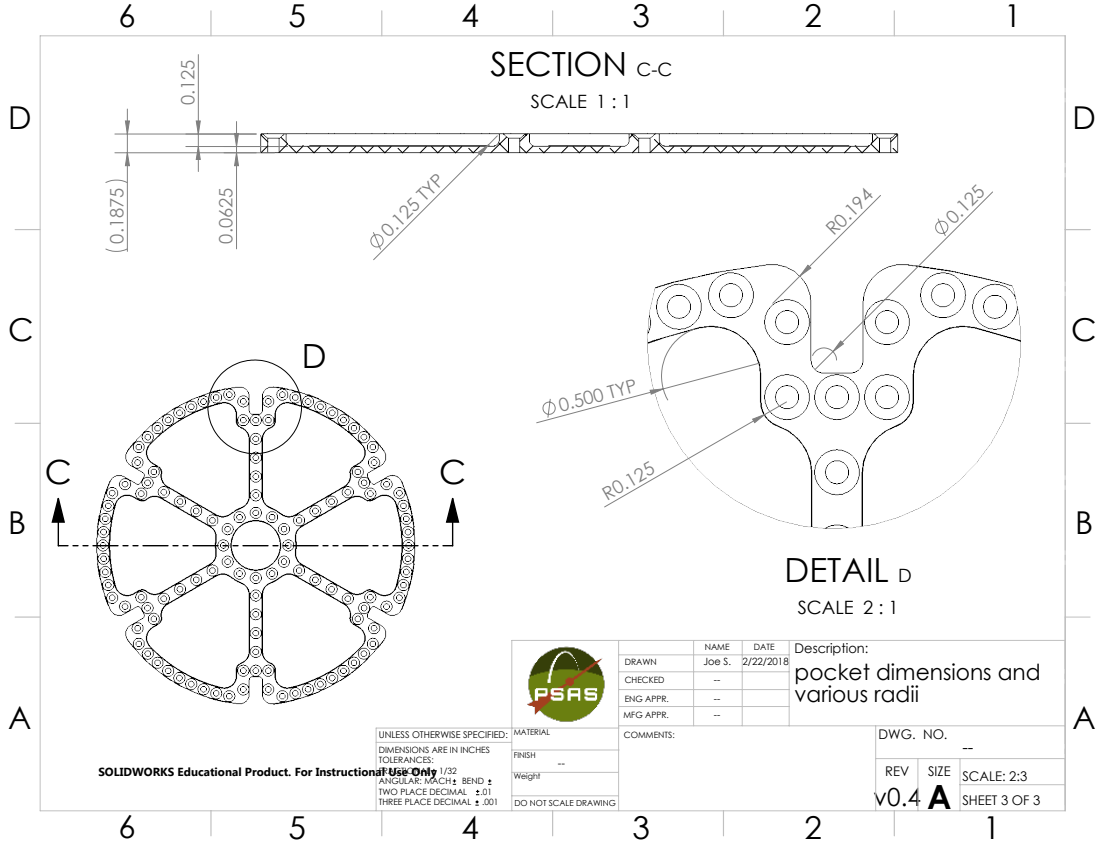
[picture p36: page 3]
0.125 TYP; SECTION C-C; SCALE 1 : 1; 0.500 TYP; DETAIL D; SCALE 2 : 1; REV; SCALE: 2:3

NAME | DATE | Description: pocket dimensions and various radii

DRAWN | Joe S. | 2/22/2018
CHECKED | --
ENG APPR. | --
MFG APPR. | --

UNLESS OTHERWISE SPECIFIED: | MATERIAL | COMMENTS: | DWG. NO. --

DIMENSIONS ARE IN INCHES
TOLERANCES:
FRACTIONAL 1/32

SOLIDWORKS Educational Product. For Instructional Use Only
