psas/lv3.0-camera-ring/mechanical/structure/passthroughRing.pdf

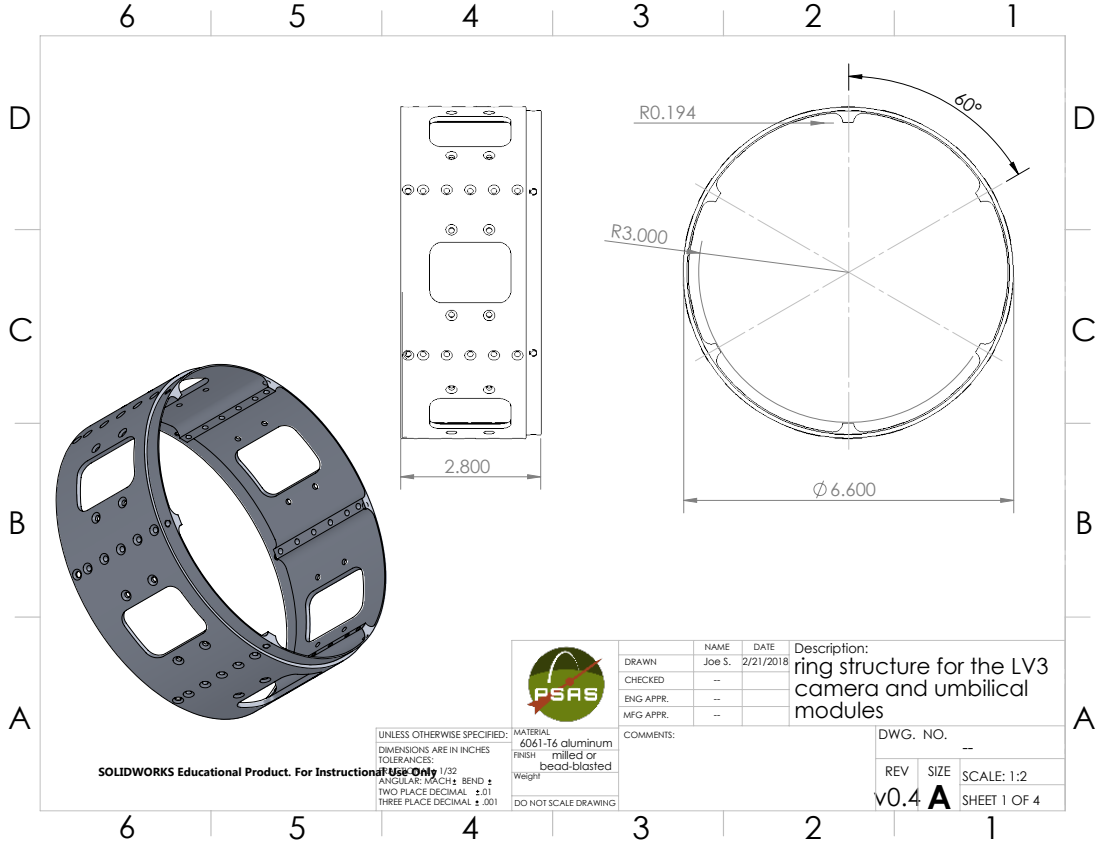
[picture p37: page 1]
FINISH; milled or; REV; SCALE: 1:2; DO NOT SCALE DRAWING; SHEET 1 OF 4

NAME | DATE | Description: ring structure for the LV3 camera and umbilical modules

DRAWN | Joe S. | 2/21/2018
CHECKED | --
ENG APPR. | --
MFG APPR. | --

UNLESS OTHERWISE SPECIFIED: | MATERIAL 6061-T6 aluminum | COMMENTS: | DWG. NO. --

DIMENSIONS ARE IN INCHES
TOLERANCES:
FRACTIONAL 1/32
ANGULAR: MACH BEND
TWO PLACE DECIMAL .01
THREE PLACE DECIMAL .001

SOLIDWORKS Educational Product. For Instructional Use Only

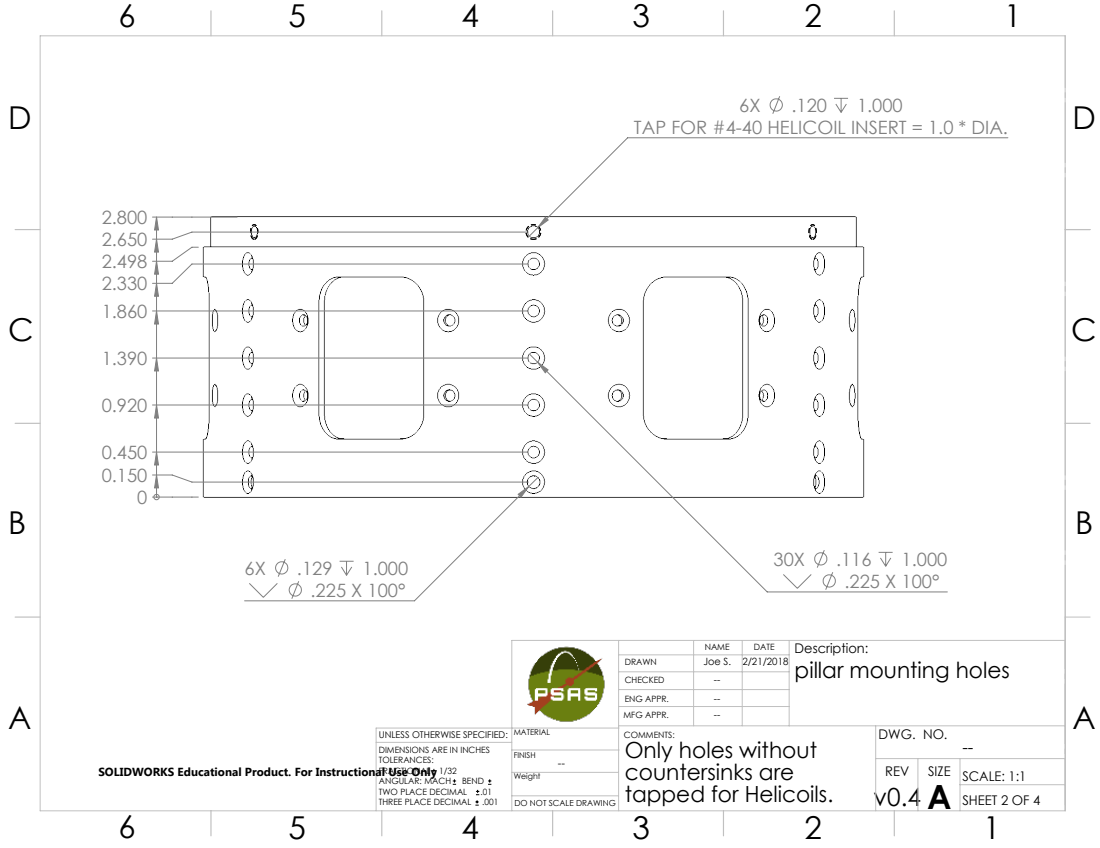
[picture p38: page 2]
REV; SCALE: 1:1

TAP FOR #4-40 HELICOIL INSERT = 1.0 * DIA.

NAME | DATE | Description: pillar mounting holes

DRAWN | Joe S. | 2/21/2018
CHECKED | --
ENG APPR. | --
MFG APPR. | --

UNLESS OTHERWISE SPECIFIED: | MATERIAL | COMMENTS: Only holes without countersinks are tapped for Helicoils. | DWG. NO. --

DIMENSIONS ARE IN INCHES
TOLERANCES:
FRACTIONAL 1/32

SOLIDWORKS Educational Product. For Instructional Use Only

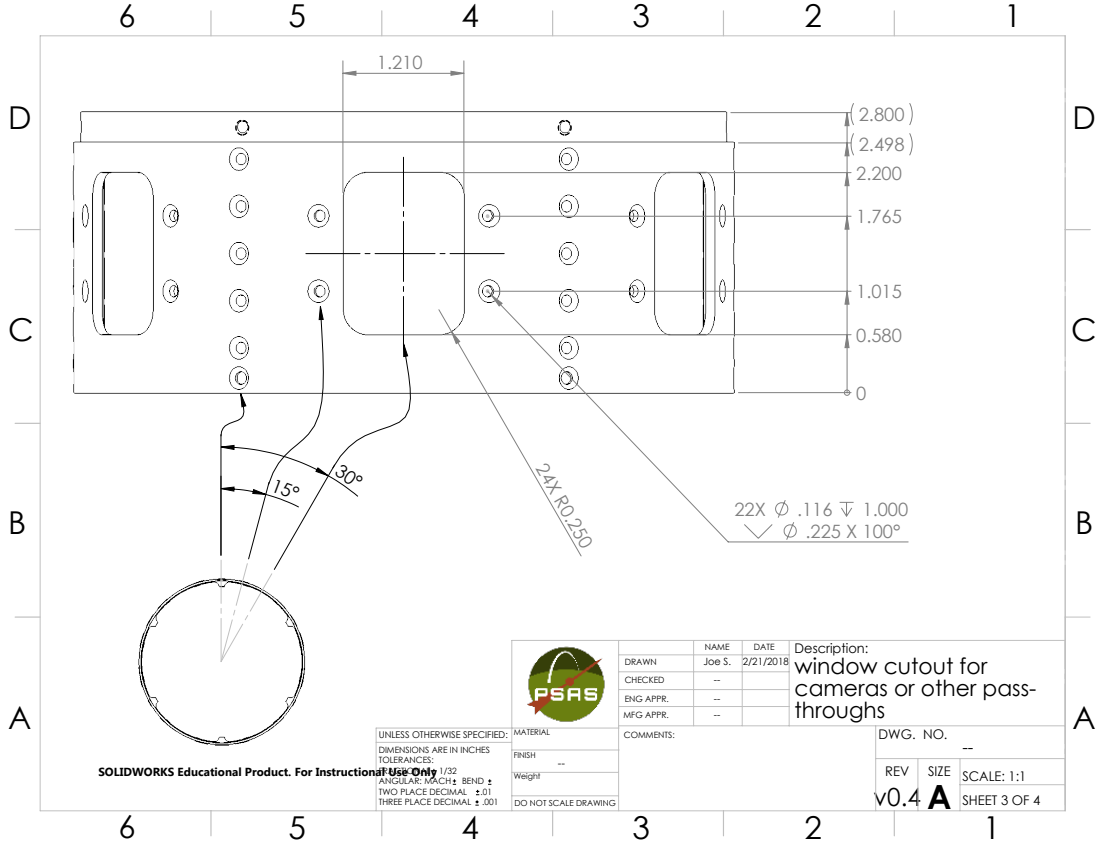
[picture p39: page 3]
REV; SCALE: 1:1

NAME | DATE | Description: window cutout for cameras or other pass-throughs

DRAWN | Joe S. | 2/21/2018
CHECKED | --
ENG APPR. | --
MFG APPR. | --

UNLESS OTHERWISE SPECIFIED: | MATERIAL | COMMENTS: | DWG. NO. --

DIMENSIONS ARE IN INCHES
TOLERANCES:
FRACTIONAL 1/32

SOLIDWORKS Educational Product. For Instructional Use Only

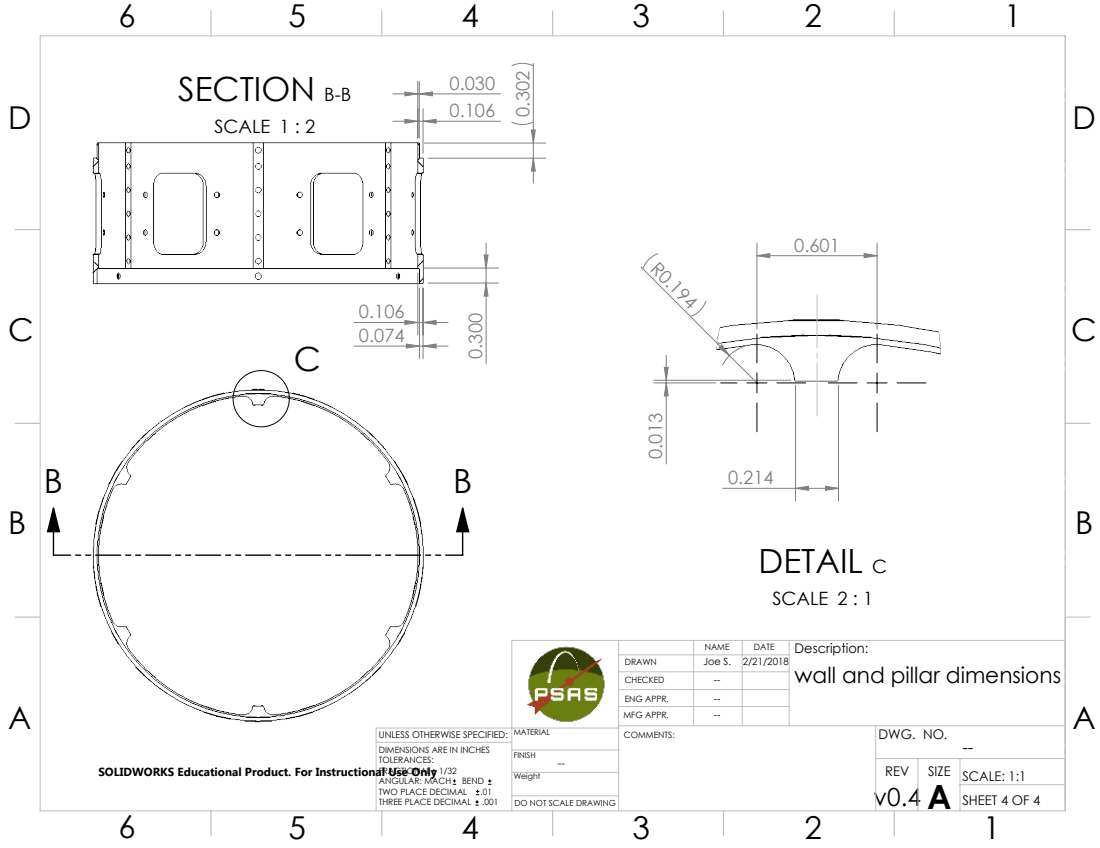
[picture p40: page 4]
SECTION B-B; SCALE 1 : 2; DETAIL C; SCALE 2 : 1; REV; SCALE: 1:1

NAME | DATE | Description: wall and pillar dimensions

DRAWN | Joe S. | 2/21/2018
CHECKED | --
ENG APPR. | --
MFG APPR. | --

UNLESS OTHERWISE SPECIFIED: | MATERIAL | COMMENTS: | DWG. NO. --

DIMENSIONS ARE IN INCHES
TOLERANCES:
FRACTIONAL 1/32

SOLIDWORKS Educational Product. For Instructional Use Only
