psas/lv3.0-camera-ring/(commit log)

2018-02-21 changed holes to match the other standard rings
    [360_RunCam_Ring.SLDPRT]
2018-02-21 simplified bulkhead mounting
    [360_RunCam_Ring.SLDASM, Camera Bulkhead.SLDPRT, bulkheadBracket.SLDPRT]
2018-02-21 prettied up the bulkhead
    [Camera Bulkhead.SLDPRT]
2018-02-21 rigged bulkhead for design optimization
    [Camera Bulkhead.SLDPRT]
2018-02-21 First thoughts on the camera controller. A bit more thought than we've given before. Next up: some circuitry.
2018-02-21 revised bulkhead-module mounting
    [Camera Bulkhead.SLDPRT, bulkheadBracket.SLDPRT]
2018-02-21 added mounting screws to camera housing
    [360_RunCam_Ring.SLDPRT, RunCam Cradle.SLDASM, RunCam Cradle.SLDPRT]
2018-02-21 revised inward side of camera housing
    Also explicitly added the metric fasteners to the assembly.
    [M2x10_torx_buttonHead_92832A113_CLASS 8.8 TORX BUTTON-HEAD SOCKET CAP SCREW.SLDPRT, RunCam Cradle.SLDASM, RunCam Cradle.SLDPRT]
2018-02-21 clipped washer retains SD card
    [4-40x0.375_torx_socketHead_92610A106_BLACK-OXIDE ALLOY STEEL SOCKET HEAD CAP SCREW.SLDPRT, No4x0.312_clippedWasher_96025A124_STEEL ANTI-ROTATING CLIPPED WASHER.SLDPRT, No4x0.562_doubleClippedWasher_96025A172_STEEL ANTI-ROTATING CLIPPED WASHER.SLDPRT, RunCam Cradle.SLDASM, RunCam Cradle.SLDPRT]
2018-02-21 increased bulkhead strength
    If SW can be trusted, it should be good to 150 pounds force at FS=2,
    assuming the screws don't fail.
    [Camera Bulkhead.SLDPRT]
2018-02-21 general-purpose holes
    [360_RunCam_Ring.SLDASM, 360_RunCam_Ring.SLDPRT, Camera Bulkhead.SLDPRT]
2018-02-21 created drawing of the camera ring
    [360_RunCam_Ring.SLDDRW, 360_RunCam_Ring.SLDPRT]
2018-02-21 added comments/descriptions to pages
    [360_RunCam_Ring.SLDDRW]
2018-02-22 technical drawing of the bulkhead bracket
    [bulkheadBracket.SLDDRW]
2018-02-22 ignore Vim swap, SW simulation, and STL
2018-02-22 extended the bulkhead to fill all gaps
    [Camera Bulkhead.SLDPRT]
2018-02-22 updated hole styles/positions
    [360_RunCam_Ring.SLDASM, 360_RunCam_Ring.SLDDRW, 360_RunCam_Ring.SLDPRT]
2018-02-22 increased SCF of the bulkhead
    (SCF is swiss cheese factor)
    [Camera Bulkhead.SLDPRT]
2018-02-22 changed the flange to not rely on the bulkhead
    Aaaaand, I forgot that we flip it around...
    I'll have to mess with the screw holes on the main ring to make them
    symmetrical about the window.
    [RunCam Cradle.SLDPRT]
2018-02-22 symmetrized pillar holes around windows
    [360_RunCam_Ring.SLDDRW, 360_RunCam_Ring.SLDPRT]
2018-02-22 fixed symmetry problem with cradle and bulkheads
    [360_RunCam_Ring.SLDASM, Camera Bulkhead.SLDPRT, RunCam Cradle.SLDASM, RunCam Cradle.SLDPRT]
2018-02-22 added nut traps; redid SD card retainer
    [RunCam Cradle.SLDPRT]
2018-02-22 drawings of the bulkhead; updated drawings
    [Camera Bulkhead.SLDDRW, bulkheadBracket.SLDDRW, bulkheadBracket.SLDPRT]
2018-02-27 moved the camera further in; adjusted cowling
    [RunCam Cradle.SLDASM, RunCam Cradle.SLDPRT]
2018-02-27 fixed clearance on lens safety
    [RunCam Cradle.SLDPRT]
2018-02-27 removed washer thingy
    [RunCam Cradle.SLDASM, RunCam Cradle.SLDPRT]
2018-02-27 added camera retention
    [RunCam Cradle.SLDASM, RunCam Cradle.SLDPRT]
2018-02-28 smoothed inside features
    [RunCam Cradle.SLDPRT]
2018-02-28 added a dogbone fillet to the outer bezel
    [RunCam Cradle.SLDPRT]
2018-02-28 created the window plug
    [windowPlug.SLDPRT]
2018-02-28 started umbilical assembly; minor tweak to plug
    [umbilicalRing.SLDASM, windowPlug.SLDPRT]
2018-03-01 started a battery box
    [batteryBox.SLDPRT]
2018-03-01 added fasteners to battery box
    [batteryBox.SLDASM, batteryBox.SLDPRT]
2018-03-01 arranged the camera module to fit the battery
    [RunCam Cradle.SLDASM]
2018-03-01 added ziptie slots
    [batteryBox.SLDPRT]
2018-03-01 foam spacer for batter box
    [batteryBox.SLDASM, batteryBox.SLDPRT, batteryBox_zipTie.sldprt, batteryFoamCushion.SLDPRT]
2018-03-01 added various enhancements for 3D printing the box
    [batteryBox.SLDASM, batteryBox.SLDPRT, batteryBox_zipTie.sldprt]
2018-03-01 made a drawing of the foam sheet
    [batteryFoamCushion.SLDDRW]
2018-03-01 made a board for the master camera controller
    [cameraMasterBoard.SLDPRT]
2018-03-01 refined the shape of the master controller board
    [cameraMasterBoard.SLDPRT]
2018-03-01 revised dimensions of master controller board
    [cameraMasterBoard.SLDDRW, cameraMasterBoard.SLDPRT, cameraMasterBoard2.SLDDRW, cameraMasterBoard2.SLDPRT]
2018-03-01 brought the board closer to the brackets
    Also made a PDF :)
    [cameraMasterBoard2.SLDDRW, cameraMasterBoard2.SLDPRT]
2018-03-01 moved the revised board to the plain name
    [cameraMasterBoard.SLDDRW, cameraMasterBoard.SLDPRT, cameraMasterBoard2.SLDDRW, cameraMasterBoard2.SLDPRT]
2018-03-01 Camera controller PCB, according to Joe's drawings. No schematic yet.
    [camera-controller.brd, camera-controller.sch]
2018-03-09 renamed mechanical directory; moved stuff to COTS/
    [0900-0-15-20-76-14-11-0-Housing.SLDPRT, 360_RunCam_Ring.SLDDRW, 360_RunCam_Ring.SLDPRT, 4-40x0.375_torx_socketHead_92610A106_BLACK-OXIDE ALLOY STEEL SOCKET HEAD CAP SCREW.SLDPRT, 813-22-0xx-30-000101-Single.SLDPRT, Cam-gopro-lens.SLDPRT, Camera Bulkhead.SLDDRW, Camera Bulkhead.SLDPRT]
2018-03-09 moved everything into appropriate subfolders
    [360_RunCam_Ring.SLDDRW, 360_RunCam_Ring.SLDPRT, Camera Bulkhead.SLDDRW, Camera Bulkhead.SLDPRT, Camera Control Board.SLDPRT, Camera Cradle Clamp.SLDPRT, RunCam Cradle.SLDASM, RunCam Cradle.SLDPRT]
2018-03-09 renamed things to consistent style
    Also removed obsolete files
    [Camera Control Board.SLDPRT, Camera Cradle Clamp.SLDPRT, bulkhead.SLDDRW, bulkhead.SLDPRT, passthroughRing.SLDDRW, passthroughRing.SLDPRT, runCamCradle.SLDASM, runCamCradle.SLDPRT]
2018-03-09 relinked SW CAD after renaming
    [batteryBox.SLDASM, batteryFoamCushion.SLDDRW, bulkhead.SLDDRW, bulkheadBracket.SLDDRW, cameraMasterBoard.SLDDRW, passthroughRing.SLDDRW, runCamCradle.SLDASM, umbilicalRing.SLDASM]
2018-03-09 created a cradle for the horizontal camera
    [4-40_heatInsert_93365A122_BRASS HEAT-SET INSERT FOR PLASTICS.SLDPRT, 4-40_insert_99362A200_BRASS TAPPING INSERT FOR PLASTICS.SLDPRT, cameraSocket.SLDPRT]
2018-03-09 created an assembly for horizontal cradle
    [horizontalCradle.SLDASM]
2018-03-09 fixed camera socket size
    [cameraSocket.SLDPRT, horizontalCradle.SLDASM]
2018-03-09 prototype of the high-angle axial camera
    [axialCradle.SLDASM, axialCradle.SLDPRT]
2018-03-12 diagram of how the FoVs overlap
    [FOVDiagram.SLDDRW]
2018-03-14 added board mounts and an extractor hole
    To use the extractor hole, you stick a screwdiver in it.
    This lets you remove the camera without poking at its lens or tugging on
    its cable!
    [axialCradle.SLDPRT]
2018-03-14 smoothed everything; ribs for board mounts
    [axialCradle.SLDPRT]
2018-03-14 poked the derrived models
    [FOVDiagram.SLDDRW, axialCradle.SLDASM]
2018-03-14 added an extraction hole to the horizontal cradle
2018-03-14 camera retainers for standard fastener lengths
    [axialCradle.SLDASM, axialCradle.SLDPRT, horizontalCradle.SLDASM]
2018-03-14 added retaining fasteners to the assemblies
    [axialCradle.SLDASM, horizontalCradle.SLDASM]
2018-03-14 updated assemblies; compactified axial cradle
    [0-80_nut_91841A115_TYPE 18-8 STAINLESS STEEL HEX NUT.SLDPRT, 0-80x0.25_capHeadScrew_91251A055_BLACK-OXIDE ALLOY STEEL SOCKET HEAD CAP SCREW.SLDPRT, axialCradle.SLDASM, axialCradle.SLDPRT]
2018-03-15 Assembly to preview the full 360 setup
2018-03-15 reference drawings for the camera cradles
2018-03-17 updated materials and appearances
    [axialCradle.SLDASM, axialCradle.SLDPRT, bulkhead.SLDPRT, bulkheadBracket.SLDPRT]
2018-03-21 bracket for mounting bulkheads to modules
    [bulkheadBracket_straightHole.SLDDRW, bulkheadBracket_straightHole.SLDPRT]
2018-03-21 correct hole size for heat-press inserts
    [axialCradle.SLDPRT]
2018-03-22 correct helicoil length in brackets
    [bulkheadBracket.SLDDRW, bulkheadBracket.SLDPRT, bulkheadBracket_straightHole.SLDDRW, bulkheadBracket_straightHole.SLDPRT]
2018-03-23 touches from LV3 assembly
    [axialCradle.SLDASM, horizontalCradle.SLDASM]
2018-04-01 cradle materials; bulhead passthrough holes
    [bulkhead_holeTemplate.SLDDRW]
2018-04-02 modified to work with new version of Split 2
    The RunCam Split 2 case changed to have a taller case with a non-flat
    shoulder. That new case doesn't fit in the cradle I made for the
    original case. So, I depended that pocket to have 0.1" clearance away
    from the shoulder of the new case. The pocket is now just insurance
    against a screw failure. The #0 screws are the things actually keeping
    the cameras in place.
    [axialCradle.SLDPRT, cameraSocket.SLDPRT]
2018-04-03 first draft of the new battery box
    [batteryDome.SLDPRT]
2018-04-04 revision of the battery dome
    [batteryDome.SLDPRT]
2018-04-04 tweaks to battery box
    [batteryBox.SLDASM, batteryDome.SLDDRW, batteryDome.SLDPRT]
2018-04-05 suggested board outline for master controller
    [batteryBox.SLDASM, batteryDome.SLDDRW, cameraMasterBoard.SLDPRT]
2018-04-08 strengthened "ears"
    [batteryDome.SLDPRT]
2018-05-13 added cable routing holes to bulkhead
    [bulkhead.SLDPRT]
2025-07-11 Notated schematic and layout. Board revision desired.
    [camera-controller.kicad_pcb, camera-controller.kicad_sch]
